rguilmet/RTK-Rover/docs/hyper-context-anchor.md

# Hyper-Context Anchor

## 1. CORE TECHNICAL ARCHITECTURE & STACK
* **Hardware:** Waveshare ESP32-S3-Touch-LCD-3.5B (`320x480` Portrait QSPI `AXS15231B` display, Capacitive Touch `0x3B`, `AXP2101` PMIC `0x34`, `TCA9554` IO Expander `0x20`, `PCF85063` RTC `0x51`, `QMI8658` 6-DOF IMU `0x6B`, `ES8311` Audio Codec `0x18`), Holybro H-RTK Unicore UM982 Dual-Antenna RTK GNSS module, and Ebyte E220-900T30S 900MHz LoRa module.
* **Firmware:** Multi-task dual-core FreeRTOS architecture (`Core 0` `RoverCore0` Priority 4 for real-time E220 $\rightarrow$ UM982 COM2 RTCM3 streaming, UM982 COM1 NMEA/`UNIHEADINGA`/`BASEINFOA` parsing, and 30 Hz 3D lever-arm kinematics with `<= 2 ms` `g_waypoint_change_seq` wakeup and zero I2C access; `Core 1` for `RoverAudio` Priority 4 `< 1 ms` ES8311 I2S `beepQueue` synthesis, `lvgl_port_task` Priority 3 LVGL 9 rendering & `0 ms` same-frame button callbacks, `RoverUI` Priority 2 exclusive `I2C_NUM_0` peripheral polling & screenshot generation, and `loopTask` Priority 1 5s debounced settings persistence + lossless SD log flushing).
* **UI:** LVGL 9 (`320x480` Portrait) with a persistent 4-row Top Status Header Bar (Date/Time with `minutesOffsetToUTC`, SI/IMP badge, Wi-Fi badge, AXP2101 battery telemetry, Master Fix badge, Master SVs, accuracy, RTCM age, Slave Fix badge, Slave SVs, baseline length, true heading, and streamlined ground-tip coordinates in 14pt Montserrat) above 5 functional screens (Multi-Mode Navigation Workspace with Tactical Guidance, Line Stakeout, and Map View on Tile 0; Field Survey Logger & Consolidated 3x4 Quick Settings Deck on Tile 1; Multi-File CSV Browser on Tile 2; Dual-Antenna Compass & Bubble Level on Tile 3; and Hardware Diagnostics & Live Observers on Tile 4) navigated strictly via the persistent Bottom Screen Navigation Bar (`< Prev`, `X/5: Title`, `Next >`). Horizontal swipe gestures are disabled.
* **Base Station Architecture (`pi4b-rtkbase`):**
  - Raspberry Pi 4B running RTKBase with RTCM TCP service on port `5016` (`tcp://127.0.0.1:5016`).
  - Stream explicitly filtered via `str2str` line: `"1006(5),1074,1084,1094,1230(10)"` producing ~625–650 Bytes/s.
  - Python hardware pacer `e220_pacer.py v3.4.0` runs as `systemd` service (`e220-pacer.service`) with `TIOCEXCL` exclusive UART locking, startup Mode 3 EEPROM verification, Channel 75 ambient noise floor probing, source `CRC24Q` validation, `GPIO 22` hardware reset watchdog (`>1.5s` `AUX` LOW), Section `5.6.2` two-regime `AUX` + silicon-calibrated Time-on-Air pacing, bi-directional 39B/45B uplink telemetry parsing / logging (`PWR:USB` vs `Bat:xx%`), remote over-the-air air-rate switching (`0x02`/`0x82`), terminal burst quiet-window enforcement, and Adaptive Constellation Interleaving at $\le 9.6\text{ kbps}$ (alternating secondary constellations across epochs while maintaining 1.0 Hz GPS 1074).
* **E220-900T30S Radio Specifications (Base & Rover Aligned, Profile Rev 2):**
  - Channel: `75` (`0x4B` = `925.125 MHz`, Rank `#1` cleanest US 902-928 MHz ISM channel in `test/e220-scan.csv` at `-96.23 dBm` avg, `+10.125 MHz` clear of `915.0 MHz` office Ecowitt weather station).
  - UART: `115,200 baud, 8N1` (`REG0 = 0xE6`).
  - Air Data Rate: `19.2 kbps` / `9.6 kbps` (supports remote over-the-air switching between 19.2k standard and 9.6k deep-woods canopy mode; also supports `2.4, 4.8, 38.4, 62.5`).
  - Subpacket Size: `200 Bytes` (`REG1` bits `[7:6] = 0b00`, native `400-byte` buffer atomic framing).
  - Mode 0 Live RSSI Register (`REG1` Bit 5 = `0x20`): Enabled (`REG1 = 0x23`), supporting `C0 C1 C2 C3 00 02` ambient noise + last-packet RSSI queries (dual `4-byte` `C1 00 <noise> <pkt>` and `5-byte` `C1 00 02 <noise> <pkt>` parser synchronized to post-`1094` inter-epoch quiet gap) without appending bytes to RX UART output (`REG3 = 0x00`).
  - Transmission Power: `21 dBm` (125 mW close/medium-range testing, keep `>= 30-100 ft` separation to avoid `+14 dB` RX LNA saturation) / `30 dBm` (1 W long-range field production) (`REG1 = 0x23` / `0x20`).
  - Transmission Mode: Transparent Mode 0 (M0=0, M1=0), LBT Disabled, Appended RSSI Byte Disabled (`REG3 = 0x00`).
  - Full Target Register Profile: `ADDH=0x00 ADDL=0x00 REG0=0xE5 REG1=0x23 CHAN=0x4B REG3=0x00` (at 19.2k).
* **Constraints & Kinematics:**
  - **Shared Internal I2C0 Bus (Core 1 Exclusive & UPS Warm-Reset Bus Clear):** All internal SMD peripherals share `I2C_NUM_0` on `GPIO 7` (SCL) and `GPIO 8` (SDA) at `400 kHz` (`.scl_wait_us = 20000` across all 6 devices including `TCA9554` and `ES8311`), polled exclusively from **Core 1** (`Touch 0x3B` @ 30Hz, `QMI8658 0x6B` 12-byte atomic burst @ 10Hz independent of LVGL graphics mutex, `PCF85063 0x51` @ 1Hz cached, `AXP2101 0x34` @ 0.5Hz) protected by `i2c_bus_mutex` with boot-time 18-clock GPIO SCL bus-clear + `STOP` (`i2c_bsp_gpio_bus_clear()`) to release any UPS-powered slave holding `SDA` LOW across warm resets, plus automatic `i2c_master_bus_reset()` recovery.
  - **Portrait IMU Coordinate Frame & 6-DOF Telemetry:** Accelerometer $a_y$ drives horizontal roll ($b_x$), $a_x$ drives vertical pitch ($b_y$). Gyroscope measures angular rate at 64 LSB/(deg/s). Resting flat produces $(0.0^\circ, 0.0^\circ)$.
  - **Storage Auto-Routing & Settings Mirroring:** MicroSD card is primary (`/sdcard/`) with internal `FFat` as emergency fallback. On boot and whenever settings change, `settings.json` is automatically mirrored from SD card to `FFat`.
  - **Device-Relative UART Pin Labels:** All pin labels (`UM982_TXD0`, `UM982_RXD0`, `UM982_TXD1`, `UM982_RXD1`, `E220_TXD`, `E220_RXD`) are named relative to the external module (`<DEV>_TXD` = module output $\rightarrow$ ESP32 RX input; `<DEV>_RXD` = module input $\leftarrow$ ESP32 TX output).
  - **Dual-Antenna Lever-Arm & Pole Height Projection:** The UM982 reports the WGS84 position of the **Master Antenna**, while the survey pole centerline sits at the midpoint ($\frac{B}{2} = 0.2775\text{ m}$ for `0.555 m` spacing) between Master and Slave antennas at height `antenna_height_m` above the ground tip. `nav_engine` projects the Master position along the 3D `UNIHEADINGA` baseline vector (`heading`, `pitch`) to eliminate orbital offset when rotating the pole.
  - **Display Orientation Independence:** True heading comes strictly from the pole-mounted UM982 dual antennas, while the handheld Waveshare's `QMI8658` IMU tracks the enclosure gravity vector (`Held Flat`, `Viewing Angle`, `Clipped Vertically to Pole`) and supports bracket tilt taring for the 2D pole bubble level.
  - **Internal `DRAM0` Conservation & Octal PSRAM Partitioning (`v0.7.5`):** Prebuilt Arduino-ESP32 `3.3.x` (`qio_opi`) sets `CONFIG_SPIRAM_MALLOC_ALWAYSINTERNAL = 4096` and `CONFIG_SPIRAM_MALLOC_RESERVE_INTERNAL = 0`, and disables `CONFIG_SPIRAM_ALLOW_BSS_SEG_EXTERNAL_MEMORY`. All non-DMA buffers $\ge 1\text{ KB}$ (`serial_logger` `32 KB`, `g_waypoints` `25.6 KB`, `rtcm_logger` `16 KB`, `nmea_logger` `8 KB`) are allocated in 8 MB Octal PSRAM via `heap_caps_malloc(..., MALLOC_CAP_SPIRAM | MALLOC_CAP_8BIT)` (keeping static `.dram0.bss` at `37.1 KB` / `18%` global dynamic RAM), and `create_rover_ui()` wraps ~400+ LVGL 9 widgets (`~50 KB`) in scoped `heap_caps_malloc_extmem_enable(64)` (restoring `4096` immediately afterward), preserving `~148 KB` of contiguous internal 8-bit/DMA SRAM for `esp_wifi_init()` / BLE and hardware DMA engines.
* **Code Style & Repository Architecture:**
  - Strict C/C++ for firmware (`src/` modular subdirectories), pure Python for auxiliary scripts (`scripts/`). Maintain existing docstrings. Semantic versioning enforced (`ROVER_FIRMWARE_VERSION` in `user_config.h` for firmware).
  - **Public Core vs. Private Sibling Repository:** Public `RTK_Rover` houses open-source firmware, generic mathematical tools (COGO solver, pacer, config utilities), schemas, and fictional sample data. Private `RTK_Rover_Private` houses real deed records, personal boundary JSON files, raw telemetry captures, and personal credentials under independent local Git version control.

---

## 2. BEHAVIORAL PROFILE & PROMPTING PERSUASION
* **Persona:** Professional Principal Level Embedded Systems Software Engineer & Geodesic/GNSS Firmware Architect.
* **Tone:** Highly terse, clinical, authoritative, and deeply rooted in physical hardware constraints (UART ringbuffer throughput, WGS84 ellipsoid radii, lever-arm kinematics, I2C bus arbitration). Zero conversational fluff. No preachy summaries.
* **Execution:** Do not output placeholder code (e.g., `// ... rest of function`). Provide complete, drop-in implementations.
* **Documentation Hygiene:** Explicitly update `docs/project_overview.md`, `docs/session_handoff.md`, and `CHANGELOG.md` in lockstep with architectural changes. Ensure all logical chunks of work are cleanly committed to Git.

---

## 3. HARD ROADBLOCKS & COMPULSIVE HALTS (WHAT NOT TO DO)
* **NEVER** assume RTKBase port 5016 carries unfiltered raw receiver output. The stream is strictly filtered via `str2str` to `1006(5),1074,1084,1094,1230(10)` (~630–650 B/s). Do not confuse it with local raw `GNSS-1.rtcm3` files.
* **NEVER** misinterpret E220 `AUX=1` as RF transmission complete! Per E220 Manual Section `5.6.2`, `AUX=1` means the 400-byte UART buffer emptied into the LLCC68 chip: `<200B` single-subpacket frames keep `AUX=1` throughout RF TX (must pace by calculated Time-on-Air + guard), while `201..400B` two-subpacket frames raise `AUX=1` the instant Subpacket 2 (`len - 200`) **starts** RF TX (must sleep `toa(len - 200) + guard` after `AUX` rising edge).
* **NEVER** forward unverified raw bytes from E220 UART directly to `UM982 COM2` without passing the `rx_stage` `CRC24Q == 0` Gatekeeper; truncated head subpackets cause `UM982 COM2` to swallow subsequent valid `0xD3` preambles.
* **NEVER** use single-precision `float` for WGS84 Latitude or Longitude storage or geodesic math (`float` has only ~24 bits of mantissa $\approx 1.5\text{ m}$ resolution at mid-latitudes, completely destroying centimeter-level RTK precision). Always use 64-bit `double` (`%.8f`).
* **NEVER** wrap I2C sensor reads inside the LVGL graphics mutex `rover_lvgl_lock()`. Sensor polling runs on Core 1 independent of LVGL render frame times, protected by `i2c_bus_mutex`.
* **NEVER** touch LVGL widget pointers from outside `lv_timer_handler()` without acquiring `rover_lvgl_lock()` and releasing via `rover_lvgl_unlock()`.
* **NEVER** use `lv_label_set_text_fmt()` with floating-point specifiers (`%f`); because the global Arduino LVGL library compiles with `LV_USE_FLOAT = 0`, `lv_vsnprintf_inner` skips `%f` without advancing `va_arg(va, double)`, causing subsequent arguments to crash (`LoadProhibited`). Always format floats with standard C `snprintf(buf, sizeof(buf), ...)` followed by `lv_label_set_text()`.
* **NEVER** execute filesystem operations (such as scanning `/survey_logged_pins.csv` or calling `save_settings()`) inside the 30 Hz UI rendering update loop (`RoverUI`) or LVGL button callbacks (`lvgl_port_task`). Dynamic identifiers must be served from the 64-entry RAM `s_stem_cache`, and debounced `save_settings()` must run strictly on the Priority-1 background `loop()` with `last_settings_change_ms` written *before* `settings_dirty = true` (signed `(int32_t)(now_ms - dirty_ts) >= 5000` check) and smart `FFat` mirror skip (`non_index_settings_equal()`) when only `active_waypoint_index` changes while MicroSD is mounted.
* **NEVER** use a process-wide boolean (`s_in_logger`) to guard `serial_logger` re-entrancy across FreeRTOS tasks, as concurrent tasks (`lvgl_port_task`, `wifi_connect`) will silently drop log lines whenever `loop()` is flushing to SD; always use task-scoped `s_io_owner_task == xTaskGetCurrentTaskHandle()` re-entrancy protection and decouple `s_serial_mux` ring-buffer pushes from `s_serial_file_mux` VFS writes.
* **NEVER** declare non-DMA ring buffers, lookup tables, or waypoint arrays $\ge 1\text{ KB}$ in static `.dram0.bss` (or rely on `EXT_RAM_BSS_ATTR`, which is inactive in prebuilt Arduino-ESP32 `sdkconfig.h`). Always allocate in Octal PSRAM via `heap_caps_malloc(..., MALLOC_CAP_SPIRAM | MALLOC_CAP_8BIT)` and keep static global dynamic RAM $\le 25\%$ (`< 80 KB`); otherwise `esp_wifi_init()` / `esp_wifi_start()` silently fails with `ESP_ERR_NO_MEM` (`0x101`) under `DebugLevel=none`, leaving Wi-Fi stuck at `WL_STOPPED (254)`, `scanNetworks() == -2`, `WiFi.begin() == 4`, and `softAPIP() == 0.0.0.0`.
* **NEVER** leave `heap_caps_malloc_extmem_enable(<4096)` lowered globally across peripheral initialization; scope `heap_caps_malloc_extmem_enable(64)` strictly around `create_rover_ui()` and restore `4096` immediately afterward so `SD_MMC`, `FFat`, `I2S`, `SPI`, `WiFi`, and `BLE` drivers never receive PSRAM pointers for internal DMA descriptors.
* **NEVER** use non-ASCII Unicode characters (such as $\pm$, $\circ$, degree symbols, arrows) in UI strings or web portals; standard ASCII equivalents (`+/-`, `deg`, `->`, `[v]`, `[^]`) must be used to ensure font glyph compatibility.
* **NEVER** trigger waypoint logging from a short-press of the BOOT button (GPIO 0). Physical BOOT button is reserved exclusively for long-press ($\ge 1.5\text{ s}$) screenshots.
* **NEVER** hardcode domain data, personal identifiers, specific coordinates, local absolute filesystem paths (`file:///C:/...`), or private configuration records directly into computational logic or algorithms. All tools must follow state-of-the-art software engineering practices: strict separation of Code (logic) and Data (schemas/CLI inputs).
* **NEVER** commit, stage, or push personal identifiable information (PII), private amateur radio callsigns, private homestead coordinates, personal LAN hostnames, or private deed boundary solving data to the Git repository. Personal data must strictly remain in the sibling repository `RTK_Rover_Private` (or `reference/` which is `.gitignore`'d).
* **NEVER** push commits to GitHub without executing the secrets audit scanner (`python scripts/check_secrets.py`) and verifying zero violations. An automated Git `pre-push` hook enforces this check.

---

## 4. LOGISTICAL STATE & COMPLETED MILESTONES
* **Completed (`v0.2.49`):**
  - **Web Portal UTF-8 / ASCII Sanitation:** Eliminated multi-byte emoji mojibake across sorting buttons and table headers. Added explicit UTF-8 meta tags and response headers.
* **Completed (Oct 29 - E220 Radio Link Integration & Pacing):**
  - **E220-900T30S Full Profile Alignment:** Synchronized Base and Rover to 115,200 baud, 19.2k air rate, 200B subpackets, CH 55 (905.125 MHz), 21 dBm, Transparent Mode (`REG0=0xE5, REG1=0x03, CHAN=0x37, REG3=0x00`).
  - **`e220_pacer.py` (v1.2.0):** Developed closed-loop hardware pacing daemon on Raspberry Pi for RTKBase TCP stream with auto-config and post-write AUX falling/rising edge monitoring.
  - **`set_e220_power.py` (v1.0.0):** Created live power level switching utility for Pi.
  - **Link Diagnostics (`test/_013`, `_014`, `_015`):** Diagnosed Test 013 baud mismatch. Verified Test 014 100% byte conservation and decoded Msg 1006 and Msg 1084 with CRC Valid. Diagnosed dropped tail packets on multi-packet frames (>200B) due to missing post-write AUX wait, resolved in `e220_pacer.py` v1.2.0. Verified Test 015 base pacing with 2,961 packets, 109.0 ms exact air time pacing, 45.8% duty cycle, and zero warnings across 11.8 minutes.
* **Completed (`v0.2.53` & `e220_pacer.py v2.7.0` - Oct 30):**
  - **Forensic Diagnosis of `_018`..`_021-new-pacer`:** Proved binomial $p = 3.49\%$ subpacket reception rate across `1,291` RF subpackets (`96.5%` physical RF packet loss), discovered E220 Section `5.6.2` `AUX` FIFO-empty timing quirk (`500 ms` false timeouts on `<=200B`, Subpacket 2 air collision on `>200B`, and four `4.0 s` Base lockups), and proved `UM982 COM2` preamble-swallowing on truncated head subpackets (`31%` valid frame loss). Confirmed Base E220 on 5V rail with `100 uF + 0.1 uF` decoupling and `serial-getty@ttyAMA0.service` disabled (single PID on `/dev/ttyAMA0`).
  - **Rover `v0.2.53`:** Implemented 1,536-byte Sliding-Window Store-and-Verify RTCM3 Gatekeeper (`CRC24Q == 0` before atomic `UM982 COM2` write; verified 13/13 frame recovery & 0 corrupt bytes on Test `_021` capture), `IO21` `AUX` edge-counter ISR, and non-blocking 5s Mode 0 `Noise/Pkt RSSI` (`dBm`) polling (`REG1 = 0x23`) displayed on Tile 4 and `[TELEM]`.
  - **Base `e220_pacer.py v2.7.0`:** Implemented Section `5.6.2` two-regime pacing (`<=200B` ToA pacing + `201..400B` `AUX` rise + Subpacket 2 ToA + `35 ms` guard), `GPIO 22` hardware reset watchdog (`>1.5 s` `AUX` LOW), `TIOCEXCL` UART lock, source `CRC24Q` gate, and startup Channel 55 ambient RF noise probe.
* **Completed (`v0.2.54` / `v0.2.55` & `e220_pacer.py v2.8.1` - Oct 30 - Nov 1):**
  - **Spectrum Scan (`test/e220-scan.csv`) & Test `_022` + 16-Test Historical Audit:** Relocated Base antenna via 4-ft coax and scanned `CH 52..77`, identifying **`CH 75` (`925.125 MHz`)** as `#1` cleanest US ISM channel (`-96.23 dBm` avg, `-94 dBm` peak, `+10.125 MHz` clear of `915.0 MHz` Ecowitt). Decoded Test `_022` raw `rtcm-base_*.txt` Mode 0 RSSI bytes (`C1 00 A1 E3` = `-95 dBm` noise / `-29 dBm` packet; `C1 00 9E E0` = `-98 dBm` noise / `-32 dBm` packet), proving ultra-clean Rover self-noise, `4-byte` MCU RSSI reply format, and close-range indoor `+21 dBm` TX + `+14 dB` RX LNA front-end compression at `~5 m`. Audited all 16 historical wire-taps (`_005`..`_022`), proving native `400-byte` buffer atomic framing delivered `223` intact `> 200B` frames (`Fix: 4`) at `38.4k`/`62.5k` vs `0` across `8` consecutive `19.2k` tests (passive `32 MHz` `XTAL` thermal/carrier drift on 1W PA bursts).
  - **Base `e220_pacer.py v2.8.1` & `e220-pacer.service`:** Restored `38.4 kbps` Air Data Rate (`REG0 = 0xE6`), migrated to `CH 75` (`925.125 MHz`, `CHAN = 0x4B`), calibrated `estimate_subpacket_air_s()` to measured `AUX_low` silicon timing (`148.1 ms` for `200B` @ `19.2k` -> `82.2 ms` for `200B` @ `38.4k`), and added dual `3/4-byte` ambient noise probe parsing.
  - **Rover `v0.2.55`:** Added `ROVER_E220_PROFILE_REV = 2` one-time `/settings.json` auto-migration (`CH 75 / 38.4k` without overwriting Wi-Fi or geometry), dual `4-byte` / `5-byte` Mode 0 RSSI reply parser (`80 ms` timeout), epoch-synchronized post-`1094` RSSI polling, hardware AUX edge counter ISR, and granular RTCM message telemetry (`1006`, `1074`, `1084`, `1094`, `1230`) with strict ASCII serial formatting.
* **Completed (Nov 2-3, 2026 - Sibling Architecture & Cadastral Decoupling Phases 1-5):**
  - **Git History Sanitization & Automated Pre-Push Protection (Phase 1):** Force-purged private tokens from git history. Implemented parameterized scanner `scripts/check_secrets.py v1.1.0` dynamically loading unversioned `.secrets.local`. Installed active `.git/hooks/pre-push` verification hook.
  - **Dedicated Sibling Repository `RTK_Rover_Private` (Phase 2):** Initialized independent local git tracking at `../RTK_Rover_Private`. Migrated 22 registered deed PDFs, historical solvers, raw wiretaps, and private configurations. Scrubbed all private assets from public `RTK_Rover`.
  - **Cadastral Schema & Generic COGO Engine `cogo_solver.py v1.1.0` (Phase 3):** Published standard schema `docs/schemas/cadastral_schema.json` and fictional reference dataset `examples/subdivision_demo.json`. Developed generic COGO engine with WGS84 geodesic projections, automatic grid convergence calibration, loop misclosure ratio evaluation, Bowditch adjustment, circular curve solving, adjoiner snapping, and multi-format exporters (Rover 19-column CSV, Google Earth KML, RFC 7946 GeoJSON, AutoCAD DXF, and ASCII reports).
  - **Homestead Parcel Extraction & Sub-Millimeter Parity Validation (Phase 4):** Modeled 9 property traverses and ROW curves in `RTK_Rover_Private/cadastral/homestead_parcels.json`. Verified sub-millimeter mathematical parity against historical solvers across all 37 benchmark points (max delta $0.7834\text{ mm}$, 100% PASS). Archived legacy solvers to `cadastral/legacy/`.
  - **Master Documentation Audit & Clean Release Verification (Phase 5):** Synchronized `README.md`, `docs/project_overview.md`, `GEMINI.md`, `docs/hyper-context-anchor.md`, `docs/session_handoff.md`, and `docs/cogo_solver_guide.md`. Executed full pre-push audit with 100% clean status.
* **Completed (Nov 4-5, 2026 - Bi-Directional LoRa, Visual Overhaul, Interleaving & Phase 5 Navigation `v0.5.0`..`v0.6.0`):**
  - **Bi-Directional Telemetry & Remote Air-Rate Switching (`v0.5.0`..`v0.5.1`):** Developed 39-byte CRC16-protected telemetry frame (`0xAA 0x55`) streaming sub-millimeter coordinates, fix quality, satellite counts, heading status, and battery telemetry from Rover to Base in the half-duplex quiet window. Implemented zero-credential touchscreen remote air-rate switching (`19.2k` <-> `9.6k`) with automatic 60s rollback watchdog.
  - **Line Stakeout Mode & Map View with Zoom/Pan (`v0.5.2`):** Implemented tri-state navigation badge cycling between Tactical Guidance, Line Stakeout, and Map View. Overhauled Line Stakeout with 4-row readout (16pt offset magnitude, ASCII steer cues `<<<`/`>>>`, station progress, and deed bearing), Point A/B baseline with traverse chevron, perpendicular tie-line, and one-tap line swap (`[<-> SWAP]`). Implemented interactive 2D Map View with single-touch drag pan, right-edge HUD Zoom buttons (`[+]`, `[-]`, `[FIT]`, `[CTR]`), boundary polyline with closed loop, waypoint pins, breadcrumbs, and live heading beam.
  - **Rate-Adaptive LoRa Truncation & Settings Dual-FS Sync (`v0.5.2`):** Scaled broken-frame truncation timeouts to prevent multi-subpacket frame drops at slower baud rates (650 ms at 9.6k, 1200 ms at 4.8k, 280 ms at 19.2k). Fixed settings dual-FS synchronization in web portal `handleUpload()`, ensuring simultaneous mirror writes to both FFat and MicroSD.
  - **Adaptive Constellation Interleaver & Font Fix (`v0.5.3` & `e220_pacer.py v3.2.0`):** Replaced undeclared Montserrat 20 with Montserrat 16 in LVGL port to resolve Arduino IDE compilation error. Implemented self-adaptive constellation interleaver in `e220_pacer.py v3.2.0` to prevent 9600 baud channel saturation (GPS 1074 sent at 1.0 Hz; GLONASS 1084, Galileo 1094, BeiDou 1124 alternated across epochs; guaranteed 200 ms quiet window even when terminal frames are skipped).
  - **Phase 5 Navigation, Cadastral Ordering & Deep-Woods Heading Fallback (`v0.6.0`):** Implemented signed `poly_order` sequence schema in CSV loader and Map View renderer (closed polygon loops for positive order, dashed tie-lines for $-k$ ties, standalone for 0). Decluttered Line Stakeout canvas. Eliminated touch latency (20 ms LVGL delay + in-memory RAM suffix cache). Implemented velocity-independent $\ge 0.70\text{ m}$ displacement heading ("Walk 3 Steps") and QMI8658 gyro yaw tracking (60s hold) preventing heading loss under dense forest canopy.
  - **Rover Telemetry Expansion for ANT2 Observability & Lockstep Pacer (`v0.6.1` & `e220_pacer.py v3.3.0`):** Expanded binary uplink telemetry from 39 to 45 bytes (+6B) adding secondary antenna fix status (`SLV_FIX`/`SLV_FLT`), measured 3D baseline length (`baseline_mm`), crossbar pitch (`baseline_pitch_cdeg`), and explicit heading source (`DUAL_FIX`, `WALK`, `GYRO`, `COG`, `HOLD`). Implemented dual-format auto-detecting unpacker in `e220_pacer.py v3.3.0` with extended console heartbeat, RAM tmpfs JSON, and daily CSV columns.
  - **Telemetry Fusion Core Sync & Pure ASCII Heartbeat (`v0.6.2` & `e220_pacer.py v3.3.1`):** Synchronized telemetry state feed to Core 1 post-sensor-fusion (fixing zero battery `0% (0.00V)` and `[NONE]` heading bugs), aligned `ant2_fix_type` strictly with moving-baseline status (`SLV_FIX` only when integer locked; `NONE` when baseline rejected), and replaced Unicode degree symbols with clean ASCII `deg` eliminating terminal mojibake (`Â°`).
* **Completed (Nov 5-6, 2026 - Dual-Power UPS, Spacing Overhaul, Wi-Fi Netif Recovery & Internal `DRAM0` / PSRAM Architecture `v0.7.0`..`v0.7.5`):**
  - **Dual-Power & Hot-Swap UPS Architecture (`v0.7.0` & `e220_pacer.py v3.4.0`):** Configured AXP2101 PMIC constant-current charging to $500\text{ mA}$ for safe LiPo buffer maintenance. Implemented 14-bit VBUS line voltage monitoring (`vbus_voltage_v >= 4.0V`) with 2-cycle hysteresis filter: external 5V pack powers high-drain UM982 and E220 1W LoRa radio, while the internal battery keeps the ESP32-S3 and LCD continuously alive across power interruptions with zero rebooting. Added configurable auto-shutdown battery timer (`auto_shutdown_battery_min`, default 5 min). Re-architected Row 1 header spacing and minimalist power badge (`[USB] 5.04V+` / `[Bat] 85% 3.92V`). Base Station pacer updated to `v3.4.0` formatting power as `PWR:USB` vs `Bat:xx%`.
  - **Wi-Fi Portal IP Fix & Deep-Woods Gyro Freeze (`v0.7.1`):** Resolved SoftAP fallback `0.0.0.0` IP bug with static IP configuration (`192.168.4.1`) and readiness polling. Added fast-path bypass for unconfigured SSIDs. Eliminated stationary heading gyro drift by increasing deadband to $1.5^\circ/\text{s}$ and freezing heading (`HDG HLD` at $0.0^\circ/\text{s}$ drift), with active pivot tracking (`HDG GYRO`) and 3.0-second walk persistence (`HDG WALK`).
  - **Wi-Fi Multi-State Visual Cues & Core v3.3.12 Netif Preservation (`v0.7.2`):** Replaced destructive `WiFi.disconnect(true)` with non-destructive calls and clean SoftAP teardown, resolving Arduino-ESP32 v3.3.12 `WL_STOPPED (254)` driver halt loops. Implemented multi-state color coding on Tile 1 Wi-Fi button (`WIFI: CONN` Amber `#D97706`, `WIFI: STA` Green `#107C41`, `WIFI: AP` Violet `#7C3AED`, `WIFI: OFF` Blue `#1B6CA8`) and matching Row 1 header icons.
  - **Wi-Fi Core 1 Task Affinity (`v0.7.3`..`v0.7.4`):** Pinned background `wifi_connect` task to Core 1 at Priority 3 co-located with `arduino_events`, eliminating Core 0 RTCM task priority inversion.
  - **Internal `DRAM0` Exhaustion Root-Cause Resolution & PSRAM Migration (`v0.7.5`):** Binary ELF analysis (`xtensa-esp32s3-elf-size`) and serial timestamp delta analysis (`test/_033`) proved static `DRAM0` usage (`213.3 KB`, `.dram0.bss = 120,032 B`) plus LVGL widget heap allocations had starved `esp_wifi_init()` / `esp_wifi_start()` of internal SRAM (`ESP_ERR_NO_MEM` hidden under `DebugLevel=none`). Migrated `82,944 B` of logger/waypoint `.dram0.bss` buffers and `~50 KB` of LVGL 9 widgets to 8 MB Octal PSRAM (dropping `.dram0.bss` to `37,104 B` / `18%` global dynamic RAM), trimmed `LVGL_DMA_BUFF_LEN` to 24 lines (`15,360 B`), restored `WIFI_ALL_CHANNEL_SCAN` / `WIFI_AUTH_WPA_PSK`, and added `[MEM] Post-Setup Heap` + `WiFi.mode()` diagnostics.
  - **UPS Warm-Reset I2C0 Bus-Clear & TCA9554/ES8311 Timing Fix (`v0.7.6`):** Resolved 30 ms `RTC_SW_CPU_RST` panic loop (`E(26) i2c.master: I2C transaction timeout detected` at `esp_io_expander_new_i2c_tca9554`) caused when a warm/flash reset interrupted an active multi-byte I2C read while the AXP2101 LiPo UPS kept all 6 I2C slaves continuously powered and holding `SDA` LOW. Added 18-clock GPIO open-drain SCL bus-clear + `STOP` (`i2c_bsp_gpio_bus_clear()`), set `.scl_wait_us = 20000` + `400 kHz` + `i2c_bsp_lock()` in `tca9554` and `ES8311` drivers, and replaced fatal `ESP_ERROR_CHECK` expander calls with a 5-attempt `i2c_bsp_reinit_bus()` recovery loop.
  - **Real-Time Priority-4 Audio, Zero-Lag Same-Frame Waypoint Selection & Lossless SD Logging (`v0.7.7`):** Diagnosed and resolved `test/_034` ~1s waypoint/file button lag caused by unsigned timestamp underflow `(uint32_t)(now_ms - last_settings_change_ms)` triggering synchronous 4-file `save_settings()` (`0.8–2.18 s` `FFat` wear-leveling stall) on `RoverUI` before `beepQueue` was drained. Extracted `beepQueue` into dedicated Priority-4 `RoverAudio` task (`< 1 ms` tactile audio), added `refresh_t0_guidance_readout_immediately()` (`0 ms` same-frame readout update) + `g_waypoint_change_seq` (`<= 2 ms` Core 0 wake), moved `save_settings()` to Priority-1 `loop()` with 5s signed quiet debounce and smart `FFat` mirror skip (`non_index_settings_equal()`), rewrote `waypoint_load_csv()` with `512 B` stack chunk parsing (`< 5 ms`) and 64-entry ring `s_stem_cache`, fixed dropped concurrent SD serial logs via task-scoped `s_io_owner_task`, and added `WIFI: CONN` tap-to-cancel + instant portal readiness before NTP.
  - **Phase 8 Single-UART `UM982 COM1` Consolidation, Receiver State Audit & Auto-Detected 9-DOF `MMC5983MA` Compass (`v0.8.0` & `e220_pacer.py v3.4.1`):** Consolidated all UM982 traffic (`RTCM3` + ASCII commands TX, `NMEA`/`UNIHEADINGA`/`BASEINFOA` + command responses RX) onto `Serial1` (`COM1`, `GPIO 17/18` @ `115200` baud) with `s_com1_tx_mutex`, `4096 B` RX/TX ring buffers, and a 3-way line demultiplexer (`512 B` buffer + XOR checksum gate), freeing `Serial2` (`COM2`, `GPIO 47/48`) and ~6 KB internal `DRAM0`. Added `um982_query_receiver_state()` (`VERSIONA`, `MODE`, `CONFIG`, `LOGLIST`) and Tile 4 `[UM982 RECEIVER STATE & LOGLIST]` card. Added auto-detected `MMC5983MA` (`0x30`) 18-bit 3-axis AMR magnetometer driver (`src/mag_bsp/`) with hardware `SET`/`RESET` bridge offset cancellation, continuous `UM982 HDG FIX` True-North tare learning, iron anomaly rejection (`> 3.5 uT`), and 9-DOF heading fallback (`HDG_SRC_COMP = 7` / `HDG CMP`).
* **Current Status:** Firmware `v0.8.0` and Base Station Pacer `e220_pacer.py v3.4.1` fully built, verified, and operational. Preparing next development phase: `Field-Instrument-Core` consolidation and `RTK-Rover-Mobile` Android port with ESP32 sensor & radio bridge.
