rguilmet/RTK-Rover/docs/session_prompt.md

# Session Kickoff Prompt: RTK-Rover-Mobile

> **Usage:** Copy and paste the prompt below into a new Antigravity session to initiate the **RTK-Rover-Mobile** Android project.

---

```markdown
# Session Goal: RTK-Rover-Mobile (Android Application + ESP32 Hardware Bridge)

## 1. Project Overview & Objective
We are transitioning the user-facing survey experience of our dual-antenna RTK GNSS Rover to a dedicated Android mobile application called **`RTK-Rover-Mobile`**. 

We will use our existing **Waveshare ESP32-S3-Touch-LCD-3.5B** board as the physical **sensor and radio bridge** connected to the GNSS receiver and LoRa transceiver, communicating wirelessly with an Android smartphone running the primary user interface, cadastral mapping, NTRIP client, and survey data management.

---

## 2. System Architecture & Component Roles

```
+-------------------------------------------------------------+
|              ANDROID SMARTPHONE (RTK-Rover-Mobile)          |
|  - Modern Sunlight-Readable UI (Kotlin / Jetpack Compose)   |
|  - High-Resolution Map Engine (Google Maps / MapLibre)      |
|  - Cellular NTRIP Client (rtk2go.com:2101 / Standish Base)  |
|  - Tri-Mode Stakeout (Tactical Bullseye, Line, 2D Cadastral)|
|  - Survey Point Logging, Multi-Epoch Averaging & CSV Export |
|  - Hands-Free Audio Guidance (Proximity Geiger & Voice)     |
+------------------------------+------------------------------+
                               ^
               Bluetooth LE (NUS) / Wi-Fi UDP
                               v
+-------------------------------------------------------------+
|    WAVESHARE ESP32-S3 BRIDGE (Hardware Interface Pod)       |
|  - Holybro UM982 GNSS (COM1 @ 115200 NMEA/Heading, COM2)   |
|  - Ebyte E220 900MHz LoRa (Transparent RTCM / Telemetry)    |
|  - Onboard QMI8658 6-DOF IMU (Pole Plumb Bubble Level)      |
|  - AXP2101 PMIC Power Telemetry & LiPo Battery UPS Buffer   |
|  - 3D Lever-Arm Kinematics (Ground-Tip Projection: 1.80m)   |
|  - Local MicroSD / FFat Backup Raw Logging                  |
+-------------------------------------------------------------+
```

### Component 1: Android Mobile Application (`RTK-Rover-Mobile`)
* **Platform:** Android (Modern Android SDK, Kotlin, Jetpack Compose, Coroutines/Flow).
* **Wireless Connectivity:** BLE Nordic UART Service (NUS) for ultra-low latency, battery-efficient telemetry streaming, with Wi-Fi UDP socket as a high-bandwidth alternative.
* **Cellular NTRIP Client:** Connects over mobile cellular data to RTK2go (`rtk2go.com:2101` or `3.14.70.106:2101`), pulls mountpoint `STANDISH_ME_FN43ur`, verifies RTCM3 frames (`1006, 1074, 1084, 1094, 1230`), and streams them over BLE/Wi-Fi to the ESP32 bridge $\rightarrow$ UM982 COM2.
* **Dual RTCM Source Arbitration:** Automatically manages or falls back between Local 900MHz LoRa (E220) and Cellular NTRIP (RTK2go) based on differential age and link health.
* **Full Survey Navigation Suite (Ported from Firmware v0.7.7):**
  * **Persistent Top Status Header Bar:** Date/time, power, ANT1 fix mode, SVs, precision, RTCM age, ANT2 heading fix, baseline length, true heading, and ground-tip coordinates.
  * **Tactical Guidance & Bullseye Stakeout:** Course-Up vector guidance with concentric centimeter rings ($1\text{ m}$, $20\text{ cm}$, $2\text{ cm}$) and proximity Geiger audio cues.
  * **Cadastral Line Stakeout:** Stationing ($S$), lateral offset ($O$), steer cues (`<<<`/`>>>`), and quadrant deed bearings ($S 62^\circ 15' 12" W$).
  * **2D Cadastral Map View:** Closed boundary polygons (`poly_order > 0`), dashed tie-lines (`-k`), color-coded pins, historical route breadcrumbs, and live heading beam.
  * **Survey Point Logger:** Symmetrical prefix dropdown (`PIN`, `PIPE`, `MONUMENT`, `<DERIVED>`), multi-epoch averaging ($1\text{s}$, $5\text{s}$, $10\text{s}$, $30\text{s}$), and collision-free `_Lxxx` numbering.

### Component 2: ESP32 Smart-Pole Hardware Bridge Firmware
* **Initial Prototype Bridge Board:** Waveshare ESP32-S3-Touch-LCD-3.5B (acts as the bridge during initial software bring-up).
* **Target Smart-Pole Board (Out of the Gate for Pole Assembly):** **Waveshare ESP32-S3-Touch-LCD-3.49-V2** (`640 × 172` 3.49" IPS bar display showing the top 4-row summary of Fix/Heading/Baseline/Link/Bat/Coords, integrated **18650 battery holder** with USB-C `ETA6098` charging, MicroSD card slot, onboard `QMI8658A` 6-DOF IMU & `PCF85063A` RTC, 16MB Flash, 8MB Octal PSRAM) housed in a beam-mounted electronics box on a removable **1" square aluminum tube crossbar** (`24"` / `610 mm` to `30"` / `762 mm` dual-helix GNSS antenna spacing + 900 MHz LoRa antenna + outboard **`MMC5983MA` 3-Axis AMR Magnetometer (`0x30`)** mounted `6"`–`10"` along the aluminum beam for Dual-GNSS-auto-calibrated 9-DOF woods heading `HDG COMP`). A discrete through-hole **`NDP6020P` P-FET + `2N3904` NPN** high-side switch gated by `J3 Pin 2 (3V3)` switches `J3 Pin 1 (VBAT)` into an **`MT3608` 5.0V boost converter** powering the Holybro UM982 and Ebyte E220-900T30S, engineered with crash-safe zero/minimal data-loss resilience on sudden power loss.
* **Firmware Baseline & Consolidated `Field-Instrument-Core` Library Repo (`Documents/Arduino/libraries/Field_Instrument_Core`):** All shared C/C++ drivers (`um982_driver`, `e220_driver`, `nav_engine`, `waypoint_manager`, `mag_bsp` (`MMC5983MA` & `RM3100`), `i2c_bsp` with 18-clock GPIO bus-clear + `i2c_bsp_lock()`, `tca9554` & `ES8311` with `.scl_wait_us = 20000` + `400 kHz`, Priority-4 `RoverAudio` tone synthesizer, `lvgl_port` with 24-line DMA buffers & PSRAM widget routing, task-scoped `s_io_owner_task` crash-safe `500 ms` pre-synced MicroSD logging, and `matrix_math`/`sensor_fusion`), board profiles (`3.5B` & `3.49-V2`), **all** shared Python/Base Station/COGO/security scripts (`scripts/e220_pacer.py`, `cogo_solver.py`, `kml_to_waypoints.py`, `validate_waypoints.py`, `setup_e220.py`, `setup_um98x.py`, `analyze_rtk_log.py`, `check_secrets.py`, `install_git_hooks.py`), and **all** hardware datasheets, schematics, CAD, and technical articles (`docs/`) are consolidated into a single generic Arduino library & GitHub repository: **`Field_Instrument_Core`** (`github.com/rguilmet/Field-Instrument-Core`). This supports separate, ultra-lean Arduino sketches (`Arduino/RTK_Rover` for the `3.5B` handheld, `Arduino/RTK_Smart_Pole` for the `3.49-V2` Smart Pole, and `Arduino/Magnetic_Field_Scanner` keeping only its magnetometry-specific calibration/plotting scripts) alongside the `RTK-Rover-Mobile` Android app.
* **CRITICAL ESP32-S3 Memory Guardrail (`DRAM0` vs. Octal PSRAM):**
  * Prebuilt Arduino-ESP32 (`3.3.x`, `qio_opi`) sets `CONFIG_SPIRAM_MALLOC_ALWAYSINTERNAL = 4096` and `CONFIG_SPIRAM_MALLOC_RESERVE_INTERNAL = 0`. Wireless stacks (`esp_wifi_init()` + BLE controller) strictly require contiguous internal 8-bit/DMA SRAM (`DRAM0`) and fail silently under `DebugLevel=none` (`ESP_ERR_NO_MEM` $\rightarrow$ `WL_STOPPED 254`) if `DRAM0` is exhausted.
  * Allocate all new bridge TX/RX ring buffers $\ge 1\text{ KB}$ in Octal PSRAM via `heap_caps_malloc(..., MALLOC_CAP_SPIRAM | MALLOC_CAP_8BIT)` (never in static `.dram0.bss`), prefer lightweight `NimBLE-Arduino` over legacy Bluedroid `BLEDevice`, and verify `[MEM] Post-Setup Heap` internal free SRAM stays healthy.

---

## 3. Reference Documentation & Key Artifacts
Before beginning, review these technical specifications in the workspace:
* **Firmware Master Docs:** `RTK_Rover/README.md`, `RTK_Rover/GEMINI.md`, `RTK_Rover/docs/project_overview.md`, `RTK_Rover/docs/hyper-context-anchor.md`, `RTK_Rover/docs/session_handoff.md`, `RTK_Rover/docs/user_manual.md`.
* **Smart Pole & App Architecture:** `RTK_Rover/docs/plan_smart_pole_and_android_app.md`.
* **Cellular NTRIP Bridge Architecture:** `RTK_Rover/docs/plan_phase7_cellular_ntrip_bridge.md`.
* **Cadastral Schema & COGO Engine:** `RTK_Rover/scripts/cogo_solver.py v1.1.0` and `RTK_Rover/docs/schemas/cadastral_schema.json`.

---

## 4. Immediate Tasks for This Session
1. **Initialize Project Scaffolding:** Set up the `RTK-Rover-Mobile` Android project structure (Kotlin, Jetpack Compose, Android Gradle Plugin).
2. **Define Bridge Protocol:** Formulate the compact binary or JSON telemetry and RTCM transfer protocol between ESP32 and Android over BLE NUS (GATT characteristics for Telemetry TX, RTCM RX, Commands).
3. **Develop Android BLE Connection Manager:** Implement scanning, pairing, and automatic reconnection with the ESP32 rover bridge.
4. **Implement Android Cellular NTRIP Client:** Build background NTRIP stream client for RTK2go mountpoint `STANDISH_ME_FN43ur` with CRC24Q verification and bridge forwarding.
5. **Implement Jetpack Compose UI Skeleton:** Construct the persistent 4-row status header bar and core navigation deck.
```
