rguilmet/RTK-Rover/docs/images/E220.webp

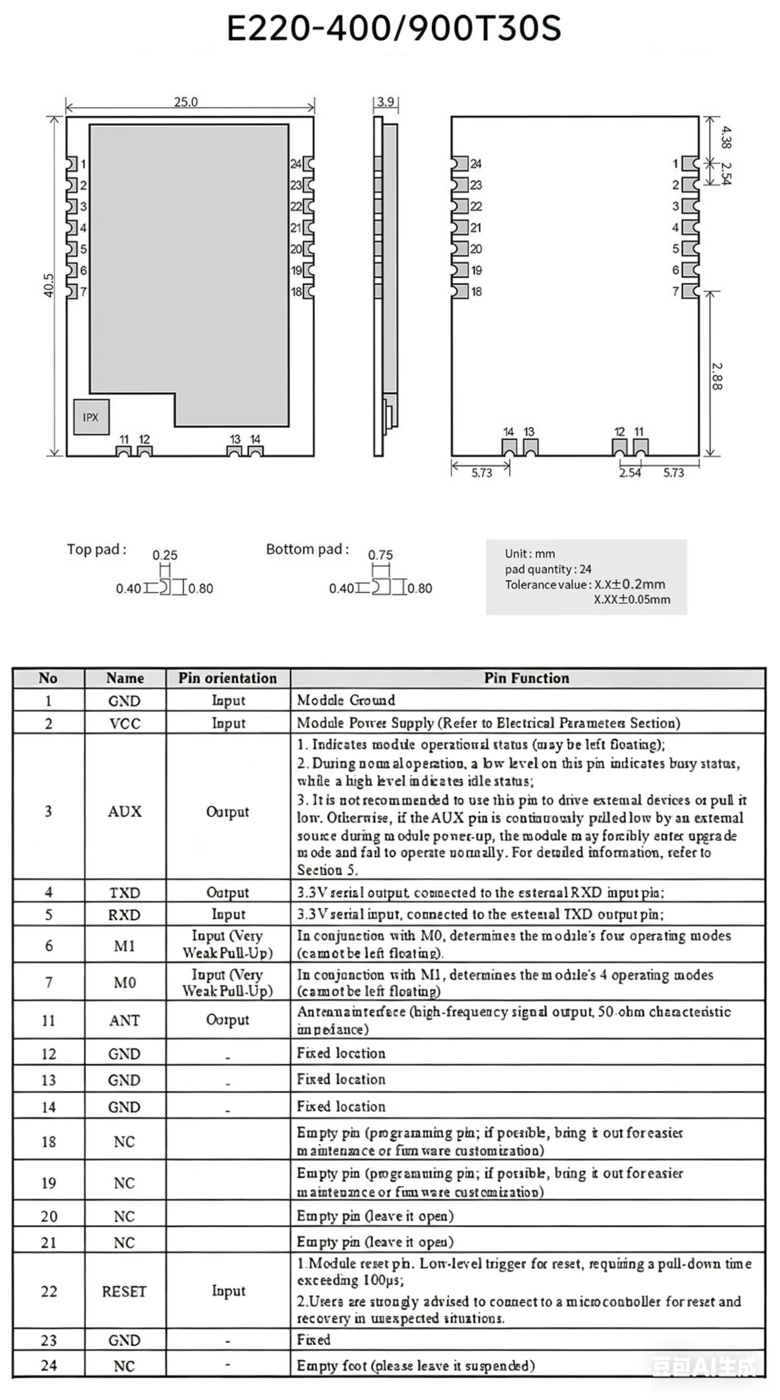
docs/images/E220.webp
