rguilmet/RTK-Rover/docs/images/ESP32-S3-Touch-LCD-3.5B-details-callouts.png

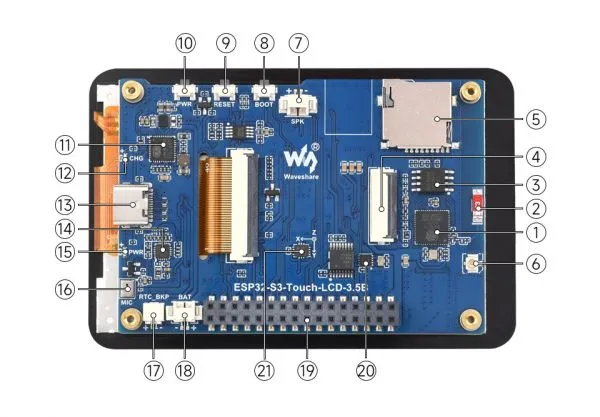
docs/images/ESP32-S3-Touch-LCD-3.5B-details-callouts.png
