rguilmet/RTK-Rover/docs/images/ESP32-S3-Touch-LCD-3.5B-Pinout-original.png

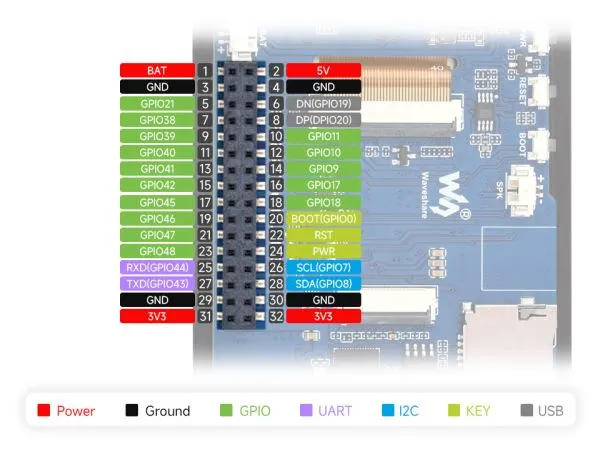
docs/images/ESP32-S3-Touch-LCD-3.5B-Pinout-original.png
