rguilmet/RTK-Rover/docs/images/Waveshare-ESP32-S3-Touch-LCD-3.5B-GPIO_Pin_Allocation.png

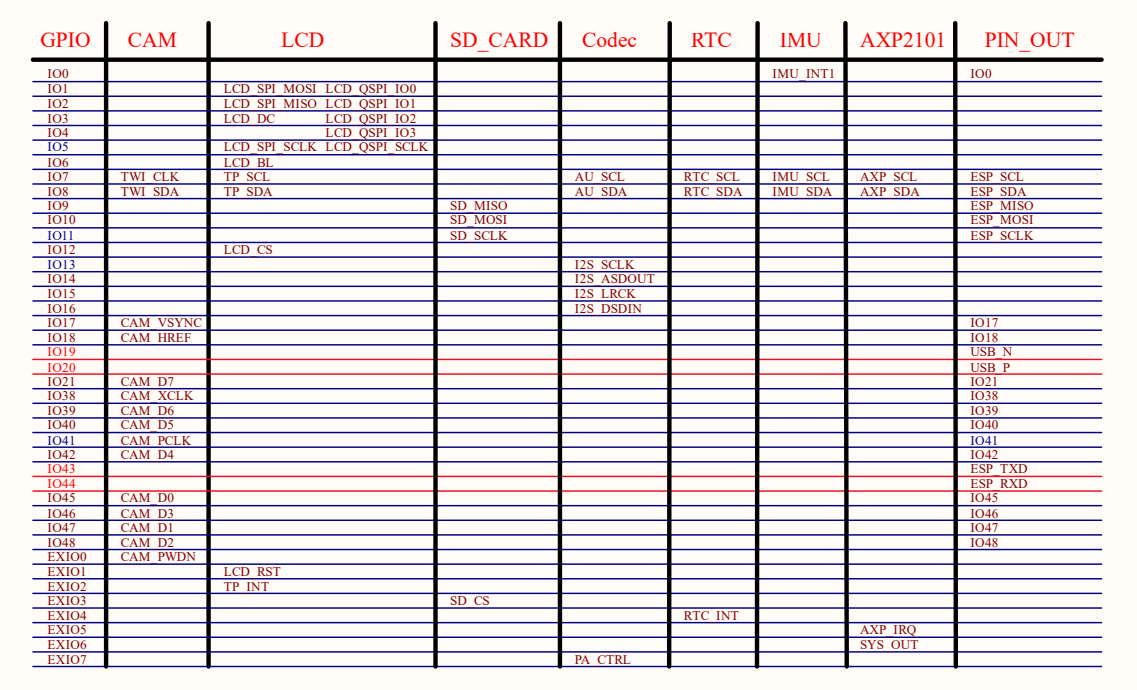
docs/images/Waveshare-ESP32-S3-Touch-LCD-3.5B-GPIO_Pin_Allocation.png
