rguilmet/RTK-Rover/docs/mechanical/ESP32-S3-Touch-LCD-3.5B-details-dimensions.webp

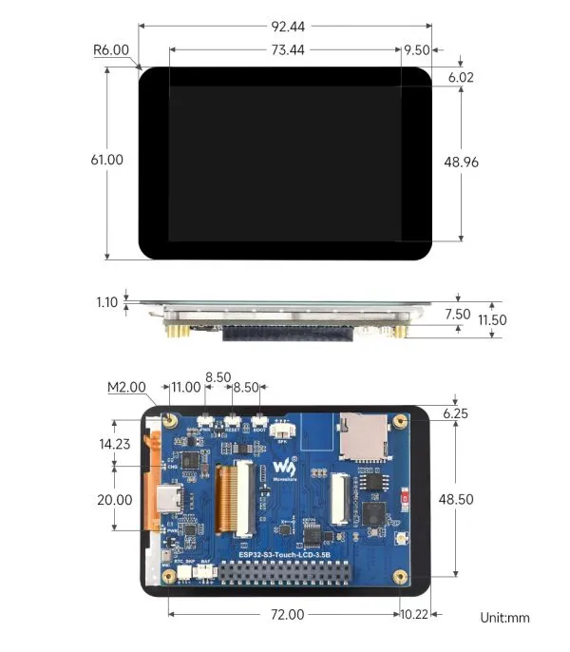
docs/mechanical/ESP32-S3-Touch-LCD-3.5B-details-dimensions.webp
