rguilmet/RTK-Rover/docs/Waveshare-ESP32-S3-Touch-LCD-3.5B-GPIO_Pin_Assignment-rev3.png

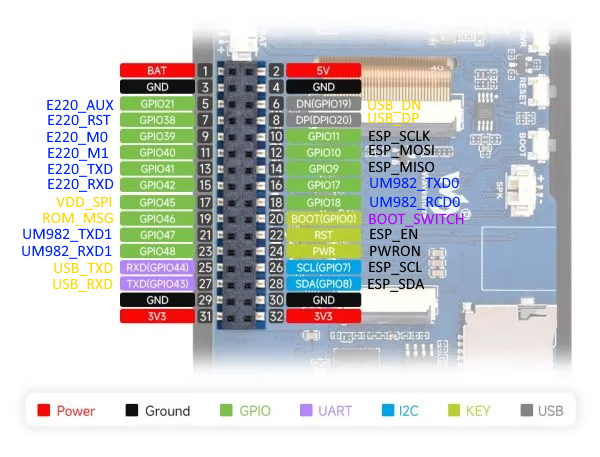
docs/Waveshare-ESP32-S3-Touch-LCD-3.5B-GPIO_Pin_Assignment-rev3.png
