rguilmet/RTK-Rover/docs/mechanical/ESP32-S3-Touch-LCD-3_5B.stp

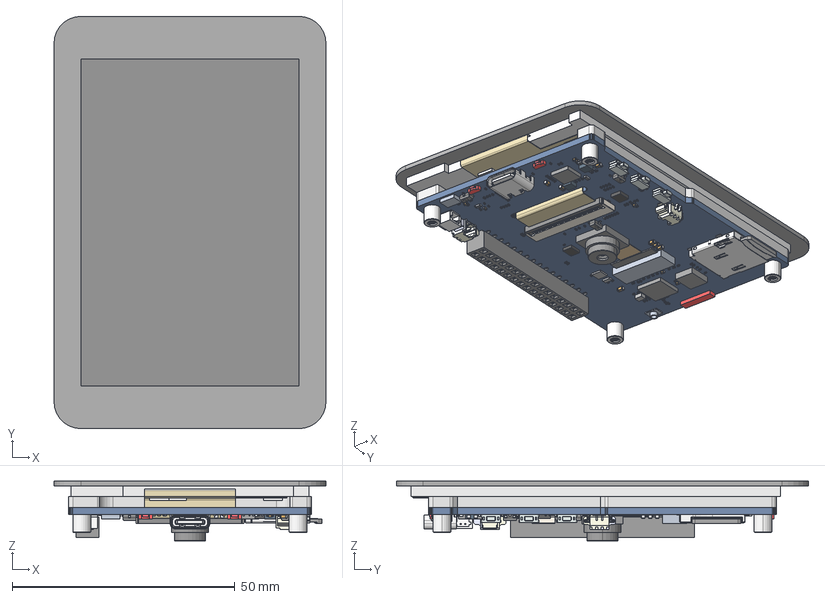
[picture p8: CAD file, 2026-10-23]
docs/mechanical/ESP32-S3-Touch-LCD-3_5B.stp
61.0 x 92.4 x 13.4 mm
JHD0350A007V1
SMTSO-M2X4-4ET x 4
BOARD
USER_LIBRARY-RES_0603-0201_1 x 59
USER_LIBRARY-RES_0603-0201_2 x 59
USER_LIBRARY-RES_0603-0201_3 x 59
USER_LIBRARY-RES_0603-0201_4 x 59
FPC0_5_2H-W__1_2_30034_1 x 40
EXTRUDED-99679
3_1_2_A x 8
USER_LIBRARY-0201_0603M__CAP_1 x 57
USER_LIBRARY-0201_0603M__CAP_2 x 57
USER_LIBRARY-0201_0603M__CAP_3 x 57
3_1_A x 7
EXTRUDED-196805 x 2
_2_1_2_3_4_AF0 x 4
_7_1_2_AF0 x 4
SOT-23 x 3
EXTRUDED-273587
EXTRUDED-273982
EXTRUDED-274377
EXTRUDED-461349
EXTRUDED-461918 x 2
HEADER-SMD-F-2_54-2X16PIN
CAMER
TYPE-C_16PIN-9X3X7_3
SWITCH-TS24CA x 3
MICRO_SD_SOCKET_PU
TF_CARD
LED
HP1_25MM-2P-SMT-HORIZONTAL x 2
MIC
CAMER-CONNECTOR
C3
PITCH1MM-2PIN-SMT-HORIZONTAL
C001
ESP32-S3-TOUCH-LCD-3_5-PMMA
