rguilmet/RTK-Rover/(list of files, cad)

Other CAD files:
docs/mechanical/ESP32-S3-Touch-LCD-3.5B-C.dwg
docs/mechanical/ESP32-S3-Touch-LCD-3.5B.dwg
