rguilmet/RTK-Rover/docs/ESP32-S3-Touch-LCD-3.5-Arduino_Setup.png

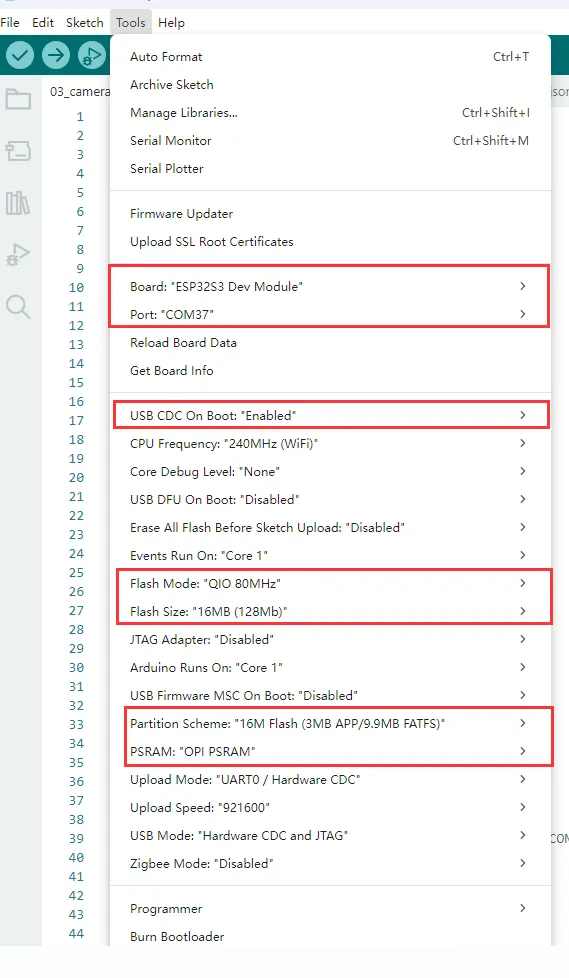
docs/ESP32-S3-Touch-LCD-3.5-Arduino_Setup.png
