rguilmet/RTK-Rover/docs/mechanical/ESP32-S3-Touch-LCD-3.5B-drawing.pdf

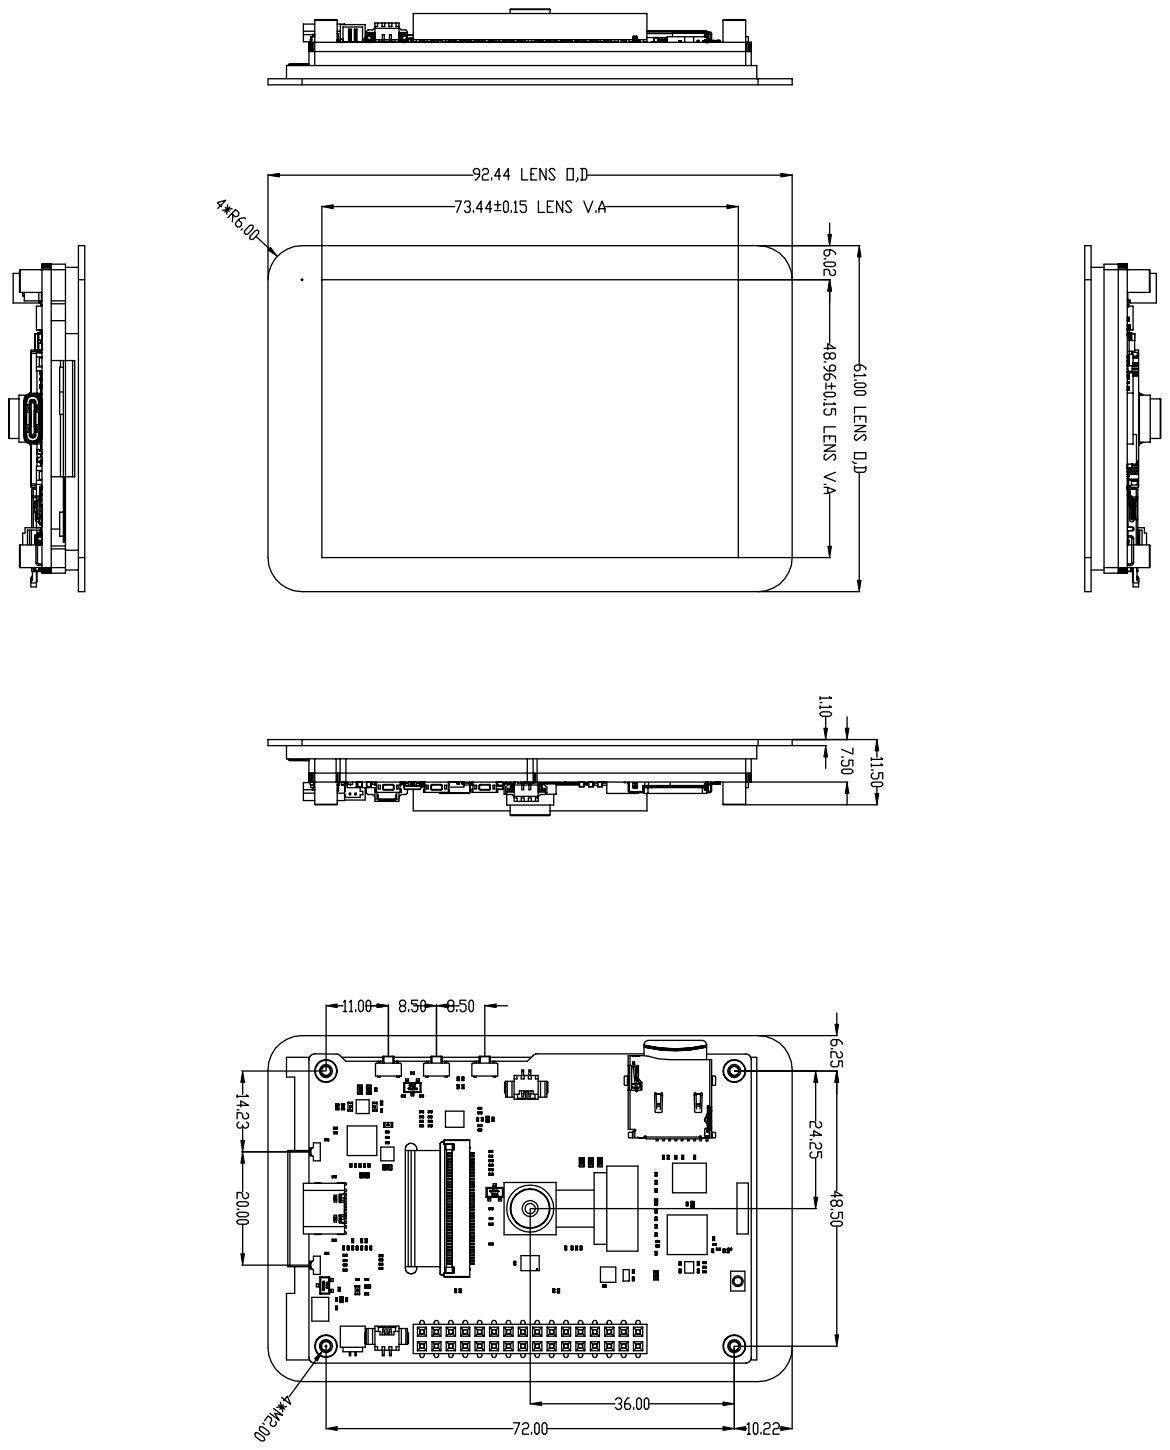
[picture p12: page 1]
