rguilmet/RTK-Rover/src/tca9554/esp_io_expander_tca9554.c

/*
 * SPDX-FileCopyrightText: 2023-2024 Espressif Systems (Shanghai) CO LTD
 *
 * SPDX-License-Identifier: Apache-2.0
 */

#include <inttypes.h>
#include <string.h>
#include <stdlib.h>
#include "esp_bit_defs.h"
#include "esp_check.h"
#include "esp_log.h"
#include "esp_io_expander.h"
#include "esp_io_expander_tca9554.h"
#include "../i2c_bsp/i2c_bsp.h"
#include "freertos/FreeRTOS.h"
#include "freertos/task.h"

/* I2C communication related */
#define I2C_TIMEOUT_MS          (250)
#define I2C_CLK_SPEED           (400000)

#define IO_COUNT                (8)

/* Register address */
#define INPUT_REG_ADDR          (0x00)
#define OUTPUT_REG_ADDR         (0x01)
#define DIRECTION_REG_ADDR      (0x03)

/* Default register value on power-up */
#define DIR_REG_DEFAULT_VAL     (0xff)
#define OUT_REG_DEFAULT_VAL     (0xff)

/**
 * @brief Device Structure Type
 *
 */
typedef struct {
    esp_io_expander_t base;
    i2c_master_bus_handle_t i2c_bus;
    i2c_master_dev_handle_t i2c_handle;
    struct {
        uint8_t direction;
        uint8_t output;
    } regs;
} esp_io_expander_tca9554_t;

static char *TAG = "tca9554";

static esp_err_t read_input_reg(esp_io_expander_handle_t handle, uint32_t *value);
static esp_err_t write_output_reg(esp_io_expander_handle_t handle, uint32_t value);
static esp_err_t read_output_reg(esp_io_expander_handle_t handle, uint32_t *value);
static esp_err_t write_direction_reg(esp_io_expander_handle_t handle, uint32_t value);
static esp_err_t read_direction_reg(esp_io_expander_handle_t handle, uint32_t *value);
static esp_err_t reset(esp_io_expander_t *handle);
static esp_err_t del(esp_io_expander_t *handle);

esp_err_t esp_io_expander_new_i2c_tca9554(i2c_master_bus_handle_t i2c_bus, uint32_t dev_addr, esp_io_expander_handle_t *handle_ret)
{
    ESP_RETURN_ON_FALSE(handle_ret != NULL, ESP_ERR_INVALID_ARG, TAG, "Invalid handle_ret");

    // Allocate memory for driver object
    esp_io_expander_tca9554_t *tca9554 = (esp_io_expander_tca9554_t *)calloc(1, sizeof(esp_io_expander_tca9554_t));
    ESP_RETURN_ON_FALSE(tca9554 != NULL, ESP_ERR_NO_MEM, TAG, "Malloc failed");

    tca9554->i2c_bus = i2c_bus;

    // Add new I2C device (explicitly configure 20ms scl_wait_us to match shared I2C0 bus clock-stretching allowance)
    esp_err_t ret = ESP_OK;
    const i2c_device_config_t i2c_dev_cfg = {
        .dev_addr_length = I2C_ADDR_BIT_LEN_7,
        .device_address = dev_addr,
        .scl_speed_hz = I2C_CLK_SPEED,
        .scl_wait_us = 20000,
    };
    ESP_GOTO_ON_ERROR(i2c_master_bus_add_device(i2c_bus, &i2c_dev_cfg, &tca9554->i2c_handle), err, TAG, "Add new I2C device failed");

    tca9554->base.config.io_count = IO_COUNT;
    tca9554->base.config.flags.dir_out_bit_zero = 1;
    tca9554->base.read_input_reg = read_input_reg;
    tca9554->base.write_output_reg = write_output_reg;
    tca9554->base.read_output_reg = read_output_reg;
    tca9554->base.write_direction_reg = write_direction_reg;
    tca9554->base.read_direction_reg = read_direction_reg;
    tca9554->base.del = del;
    tca9554->base.reset = reset;

    /* Reset configuration and register status */
    ESP_GOTO_ON_ERROR(reset(&tca9554->base), err1, TAG, "Reset failed");

    *handle_ret = &tca9554->base;
    return ESP_OK;
err1:
    i2c_master_bus_rm_device(tca9554->i2c_handle);
err:
    free(tca9554);
    return ret;
}

static esp_err_t read_input_reg(esp_io_expander_handle_t handle, uint32_t *value)
{
    esp_io_expander_tca9554_t *tca9554 = (esp_io_expander_tca9554_t *)__containerof(handle, esp_io_expander_tca9554_t, base);
    if (!i2c_bsp_lock(250)) {
        return ESP_ERR_TIMEOUT;
    }

    uint8_t temp = 0;
    uint8_t reg_addr = INPUT_REG_ADDR;
    esp_err_t ret = i2c_master_transmit_receive(tca9554->i2c_handle, &reg_addr, 1, &temp, sizeof(temp), I2C_TIMEOUT_MS);
    if (ret != ESP_OK && tca9554->i2c_bus != NULL) {
        i2c_master_bus_reset(tca9554->i2c_bus);
        vTaskDelay(pdMS_TO_TICKS(5));
        ret = i2c_master_transmit_receive(tca9554->i2c_handle, &reg_addr, 1, &temp, sizeof(temp), I2C_TIMEOUT_MS);
    }
    i2c_bsp_unlock();
    ESP_RETURN_ON_ERROR(ret, TAG, "Read input reg failed");
    *value = temp;
    return ESP_OK;
}

static esp_err_t write_output_reg(esp_io_expander_handle_t handle, uint32_t value)
{
    esp_io_expander_tca9554_t *tca9554 = (esp_io_expander_tca9554_t *)__containerof(handle, esp_io_expander_tca9554_t, base);
    value &= 0xff;
    if (!i2c_bsp_lock(250)) {
        return ESP_ERR_TIMEOUT;
    }

    uint8_t data[] = {OUTPUT_REG_ADDR, (uint8_t)value};
    esp_err_t ret = i2c_master_transmit(tca9554->i2c_handle, data, sizeof(data), I2C_TIMEOUT_MS);
    if (ret != ESP_OK && tca9554->i2c_bus != NULL) {
        i2c_master_bus_reset(tca9554->i2c_bus);
        vTaskDelay(pdMS_TO_TICKS(5));
        ret = i2c_master_transmit(tca9554->i2c_handle, data, sizeof(data), I2C_TIMEOUT_MS);
    }
    i2c_bsp_unlock();
    ESP_RETURN_ON_ERROR(ret, TAG, "Write output reg failed");
    tca9554->regs.output = value;
    return ESP_OK;
}

static esp_err_t read_output_reg(esp_io_expander_handle_t handle, uint32_t *value)
{
    esp_io_expander_tca9554_t *tca9554 = (esp_io_expander_tca9554_t *)__containerof(handle, esp_io_expander_tca9554_t, base);

    *value = tca9554->regs.output;
    return ESP_OK;
}

static esp_err_t write_direction_reg(esp_io_expander_handle_t handle, uint32_t value)
{
    esp_io_expander_tca9554_t *tca9554 = (esp_io_expander_tca9554_t *)__containerof(handle, esp_io_expander_tca9554_t, base);
    value &= 0xff;
    if (!i2c_bsp_lock(250)) {
        return ESP_ERR_TIMEOUT;
    }

    uint8_t data[] = {DIRECTION_REG_ADDR, (uint8_t)value};
    esp_err_t ret = i2c_master_transmit(tca9554->i2c_handle, data, sizeof(data), I2C_TIMEOUT_MS);
    if (ret != ESP_OK && tca9554->i2c_bus != NULL) {
        i2c_master_bus_reset(tca9554->i2c_bus);
        vTaskDelay(pdMS_TO_TICKS(5));
        ret = i2c_master_transmit(tca9554->i2c_handle, data, sizeof(data), I2C_TIMEOUT_MS);
    }
    i2c_bsp_unlock();
    ESP_RETURN_ON_ERROR(ret, TAG, "Write direction reg failed");
    tca9554->regs.direction = value;
    return ESP_OK;
}

static esp_err_t read_direction_reg(esp_io_expander_handle_t handle, uint32_t *value)
{
    esp_io_expander_tca9554_t *tca9554 = (esp_io_expander_tca9554_t *)__containerof(handle, esp_io_expander_tca9554_t, base);

    *value = tca9554->regs.direction;
    return ESP_OK;
}

static esp_err_t reset(esp_io_expander_t *handle)
{
    ESP_RETURN_ON_ERROR(write_direction_reg(handle, DIR_REG_DEFAULT_VAL), TAG, "Write dir reg failed");
    ESP_RETURN_ON_ERROR(write_output_reg(handle, OUT_REG_DEFAULT_VAL), TAG, "Write output reg failed");
    return ESP_OK;
}

static esp_err_t del(esp_io_expander_t *handle)
{
    esp_io_expander_tca9554_t *tca9554 = (esp_io_expander_tca9554_t *)__containerof(handle, esp_io_expander_tca9554_t, base);

    ESP_RETURN_ON_ERROR(i2c_master_bus_rm_device(tca9554->i2c_handle), TAG, "Remove I2C device failed");
    free(tca9554);
    return ESP_OK;
}
