rguilmet/RTK-Rover/scripts/e220_pacer.py

#!/usr/bin/env python3
# -*- coding: utf-8 -*-
"""
Module: e220_pacer.py
Description: Datasheet-Accurate Hardware-Paced Ebyte E220-900T30S LoRa Driver for RTKBase.
             Parses and CRC24Q-validates raw RTCM3 streams into complete frames and
             transmits each frame intact through the E220 400-byte FIFO using Ebyte
             E220 Manual Section 5.6.2 two-regime AUX + Time-on-Air pacing:
               - Single-subpacket frames (<= 200B): Transfer directly into an idle
                 LLCC68 FIFO without holding AUX LOW; paced deterministically by
                 calibrated LoRa Time-on-Air + receiver UART drain guard delay.
               - Two-subpacket frames (201..400B): Hold AUX LOW while Subpacket 1
                 (200B) transmits over the air, then raise AUX HIGH the instant
                 Subpacket 2 (len - 200) enters the LLCC68 FIFO and begins RF TX;
                 paced by AUX rising edge + Subpacket 2 Time-on-Air + guard delay.
             Includes GPIO 22 hardware reset watchdog if AUX ever locks LOW (>1.5s),
             POSIX exclusive UART locking (TIOCEXCL), startup EEPROM verification,
             and Mode 0 ambient RF noise floor probing (REG1 Bit 5 = 0x20) on CH 75
             (925.125 MHz, Rank #1 cleanest US ISM channel clear of 915 MHz Ecowitt).

Hardware Connections (Raspberry Pi BCM Pins, matching setup_e220.py):
  - E220 M0:    GPIO 18 (BCM) -> Pin 12
  - E220 M1:    GPIO 17 (BCM) -> Pin 11
  - E220 AUX:   GPIO 27 (BCM) -> Pin 13 (Active HIGH = Buffer Empty, LOW = Busy)
  - E220 RESET: GPIO 22 (BCM) -> Pin 15 (Active LOW hardware reset)
  - E220 TX/RX: /dev/ttyAMA0 (UART0 GPIO 14/15)

Author: Roland L. Guilmet & Antigravity
License: MIT
"""

from __future__ import annotations

import argparse
import errno
import gzip
import json
import os
import select
import shutil
import signal
import socket
import struct
import sys
import time
from typing import Optional

try:
    import serial
except ImportError:
    serial = None  # type: ignore

try:
    import RPi.GPIO as GPIO
except ImportError:
    GPIO = None

try:
    import pty
except ImportError:
    pty = None

try:
    import termios
    _TERMIOS_ERRORS: tuple[type[BaseException], ...] = (termios.error,)
except ImportError:
    _TERMIOS_ERRORS = ()


__app_name__ = "e220_pacer"
__version__ = "3.4.1"
__date__ = "2026-11-07"

# Force unbuffered output so systemd journalctl displays entries in real time
if hasattr(sys.stdout, "reconfigure"):
    sys.stdout.reconfigure(line_buffering=True)
if hasattr(sys.stderr, "reconfigure"):
    sys.stderr.reconfigure(line_buffering=True)

# Default Pin Mapping (matches setup_e220.py)
DEFAULT_PIN_M0 = 18
DEFAULT_PIN_M1 = 17
DEFAULT_PIN_AUX = 27
DEFAULT_PIN_RST = 22
DEFAULT_SERIAL_PORT = "/dev/ttyAMA0"
DEFAULT_BAUD = 115200
DEFAULT_PACKET_SIZE = 200

# Inter-frame guard delay after RF completion (allows Rover E220 17.4ms @ 115200 UART drain + 17.6ms margin)
DEFAULT_GUARD_DELAY_S = 0.035  # 35 ms

# Hardware Flow Control & Watchdog Thresholds
AUX_SINGLE_PROBE_S = 0.008     # 8 ms probe for <=200B frames (normally stays HIGH per Sec 5.6.2)
AUX_MULTI_FALL_TIMEOUT_S = 0.050  # 50 ms max wait for AUX falling edge on >200B frames (typical: 2.0 ms)
AUX_RISE_WATCHDOG_S = 1.500    # 1.5 s max AUX LOW before triggering GPIO 22 hardware reset

# Lookups for Auto-Config / Register Decode
BAUD_RATES = {1200: 0b000, 2400: 0b001, 4800: 0b010, 9600: 0b011, 19200: 0b100, 38400: 0b101, 57600: 0b110, 115200: 0b111}
AIR_DATA_RATES = {2.4: 0b010, 4.8: 0b011, 9.6: 0b100, 19.2: 0b101, 38.4: 0b110, 62.5: 0b111}
SUBPACKET_SIZES = {200: 0b00, 128: 0b01, 64: 0b10, 32: 0b11}
POWER_LEVELS = {30: 0b00, 27: 0b01, 24: 0b10, 21: 0b11}

INV_BAUD = {v: k for k, v in BAUD_RATES.items()}
INV_AIR = {0b000: 2.4, 0b001: 2.4, **{v: k for k, v in AIR_DATA_RATES.items()}}
INV_PKT = {v: k for k, v in SUBPACKET_SIZES.items()}
INV_PWR = {v: k for k, v in POWER_LEVELS.items()}

running = True


def sig_handler(signum, frame):
    global running
    running = False


def rtcm_crc24q(data: bytes) -> int:
    """Compute 24-bit RTCM3 CRC24Q over full frame (header + payload + 3-byte CRC). Returns 0 if valid."""
    crc = 0
    for b in data:
        crc ^= (b << 16)
        for _ in range(8):
            crc <<= 1
            if crc & 0x1000000:
                crc ^= 0x1864CFB
        crc &= 0xFFFFFF
    return crc


# =============================================================================
# Bi-Directional LoRa Protocol Definitions (0xAA 0x55 Framing)
# =============================================================================
ROVER_SYNC = b"\xAA\x55"
MSG_ID_TELEMETRY = 0x01
MSG_ID_REQ_SWITCH = 0x02
MSG_ID_ACK_SWITCH = 0x82

# 39-Byte Legacy Uplink Telemetry Frame Format (plen=33):
# sync(2s), mid(B), plen(B), lat(d), lon(d), height(f), h_acc_mm(H), fix(B),
# sats_m(B), sats_s(B), hdg_cdeg(H), bat_pct(B), bat_mv(H), rssi(b), noise(b), seq(B), crc(H)
FMT_TELEMETRY_LEGACY = "<2sBBddfHBBBHBHbbBH"

# 45-Byte Expanded Uplink Telemetry Frame Format (plen=39):
# sync(2s), mid(B), plen(B), lat(d), lon(d), height(f), h_acc_mm(H), fix(B),
# ant2_fix(B), baseline_mm(H), baseline_pitch_cdeg(h), hdg_source(B),
# sats_m(B), sats_s(B), hdg_cdeg(H), bat_pct(B), bat_mv(H), rssi(b), noise(b), seq(B), crc(H)
FMT_TELEMETRY = "<2sBBddfHBBHhBBBHBHbbBH"

# 10-Byte Remote Air-Rate Switch Request Format:
# sync(2s), mid(B), plen(B), target_code(B), target_chan(B), req_id(H), crc(H)
FMT_REQ_SWITCH = "<2sBBBBHH"

# 11-Byte Remote Air-Rate Switch Acknowledge Format:
# sync(2s), mid(B), plen(B), req_id(H), status(B), delay_ms(H), crc(H)
FMT_ACK_SWITCH = "<2sBBHBHH"


def crc16_ccitt(data: bytes) -> int:
    """Standard CRC16-CCITT (False: poly 0x1021, init 0xFFFF, no final XOR)."""
    crc = 0xFFFF
    for b in data:
        crc ^= (b << 8)
        for _ in range(8):
            if crc & 0x8000:
                crc = ((crc << 1) ^ 0x1021) & 0xFFFF
            else:
                crc = (crc << 1) & 0xFFFF
    return crc


class E220Pacer:
    def __init__(
        self,
        port: str = DEFAULT_SERIAL_PORT,
        baud: int = DEFAULT_BAUD,
        packet_size: int = DEFAULT_PACKET_SIZE,
        guard_delay_s: float = DEFAULT_GUARD_DELAY_S,
        pin_m0: int = DEFAULT_PIN_M0,
        pin_m1: int = DEFAULT_PIN_M1,
        pin_aux: int = DEFAULT_PIN_AUX,
        pin_rst: int = DEFAULT_PIN_RST,
        auto_config: bool = False,
        air_rate_kbps: float = 19.2,
        power_dbm: int = 21,
        channel: int = 75,
        verbose: bool = False,
        quiet: bool = False,
        log_dir: str = "~/rover_logs",
        log_retention_days: int = 30,
        max_log_mb: int = 50,
        compress_logs: bool = True,
        no_csv: bool = False,
        no_interleave: bool = False,
    ):
        self.port_name = port
        self.baud = baud
        self.packet_size = packet_size
        self.guard_delay_s = guard_delay_s
        self.pin_m0 = pin_m0
        self.pin_m1 = pin_m1
        self.pin_aux = pin_aux
        self.pin_rst = pin_rst
        self.auto_config = auto_config
        self.air_rate_kbps = air_rate_kbps
        self.power_dbm = power_dbm
        self.channel = channel
        self.verbose = verbose
        self.quiet = quiet
        self.ser: Optional[serial.Serial] = None
        self.gpio_available = GPIO is not None
        self.rssi_reg_enabled = False

        # Bi-Directional LoRa Uplink State
        self.uplink_buf = bytearray()
        self.last_rover_telemetry: dict = {}
        self.last_rover_rx_time = 0.0
        self.uplink_packets_received = 0
        self.uplink_crc_errors = 0
        self.rate_switch_count = 0
        self.watchdog_rate_switch_time = 0.0
        self.watchdog_rate_revert_time = 0.0
        self.fallback_air_rate = 19.2
        self.active_air_rate = air_rate_kbps

        # Log Retention & Storage
        resolved_log_dir = os.path.expanduser(log_dir)
        if resolved_log_dir.startswith("/root") or resolved_log_dir == "/root":
            if os.path.isdir("/home/pi"):
                resolved_log_dir = "/home/pi/rover_logs"
            elif os.environ.get("SUDO_USER") and os.path.isdir(f"/home/{os.environ.get('SUDO_USER')}"):
                resolved_log_dir = f"/home/{os.environ.get('SUDO_USER')}/rover_logs"
            else:
                # Find the first non-root interactive user directory in /home
                try:
                    candidates = [
                        os.path.join("/home", u) for u in os.listdir("/home")
                        if os.path.isdir(os.path.join("/home", u)) and not u.startswith(".")
                    ]
                    if candidates:
                        resolved_log_dir = os.path.join(candidates[0], "rover_logs")
                except Exception:
                    pass
        self.log_dir = resolved_log_dir
        self.log_retention_days = log_retention_days
        self.max_log_mb = max_log_mb
        self.compress_logs = compress_logs
        self.enable_csv = not no_csv
        self.current_log_date = ""
        self.current_log_file = None

        # Pre-create log directory immediately on startup with full access
        if self.enable_csv:
            try:
                os.makedirs(self.log_dir, exist_ok=True)
                os.chmod(self.log_dir, 0o777)
                # If created in /root, also attempt to symlink into /home candidate for convenience
                if self.log_dir.startswith("/root"):
                    for u in os.listdir("/home"):
                        uhome = os.path.join("/home", u)
                        if os.path.isdir(uhome) and not u.startswith("."):
                            ulink = os.path.join(uhome, "rover_logs")
                            if not os.path.exists(ulink):
                                try:
                                    os.symlink(self.log_dir, ulink)
                                except OSError:
                                    pass
            except OSError:
                pass

        # Telemetry counters
        self.total_bytes_in = 0
        self.total_bytes_out = 0
        self.total_packets_sent = 0
        self.total_subpackets_sent = 0
        self.total_wait_time_s = 0.0
        self.watchdog_resets = 0
        self.src_crc_errors = 0
        self.src_orphan_bytes = 0
        self.backlog_shed_frames = 0
        self.rtcm_stats: dict[int, int] = {}

        # Adaptive Constellation Interleaver State
        self.enable_interleave = not no_interleave
        self.seen_secondary_types: set[int] = set()
        self.epoch_counter = 0
        self.last_epoch_start_time = 0.0
        self.interleave_dropped_frames = 0

    def estimate_subpacket_air_s(self, n_bytes: int) -> float:
        """
        Estimate single-subpacket LoRa Time-on-Air (seconds) for E220-900T30S (LLCC68).
        Calibrated directly against Test _022 hardware AUX_low telemetry (t_uart + AUX_low = 165.0 ms
        -> 148.1 ms true Time-on-Air for 200B @ 19.2 kbps; ~0.68 net payload coding efficiency after
        LoRa preamble, explicit header, CRC16, FEC coding rate, and 3-char UART idle detect):
          - @ 38.4 kbps: 200B -> 82.2 ms, 144B -> 65.0 ms, 122B -> 58.3 ms, 27B -> 29.2 ms
          - @ 19.2 kbps: 200B -> 148.4 ms, 144B -> 114.0 ms, 122B -> 100.6 ms, 27B -> 42.3 ms
        """
        if n_bytes <= 0:
            return 0.0
        rate_bps = max(self.air_rate_kbps, 2.4) * 1000.0
        return 0.016 + ((float(n_bytes) + 16.0) * 8.0) / (rate_bps * 0.68)

    @staticmethod
    def _safe_flush(ser_obj: "serial.Serial") -> bool:
        """Drain UART TX buffer via tcdrain(), returning False cleanly if interrupted by SIGTERM/SIGINT (EINTR)."""
        while True:
            try:
                ser_obj.flush()
                return True
            except _TERMIOS_ERRORS + (OSError,) as e:
                err_no = e.args[0] if getattr(e, "args", None) else None
                if err_no == errno.EINTR:
                    if not running:
                        return False
                    continue
                if not running:
                    return False
                raise

    def _open_operational_uart(self) -> None:
        if serial is None:
            raise RuntimeError("pyserial is not installed.")
        if self.ser and self.ser.is_open:
            self.ser.close()
        try:
            self.ser = serial.Serial(self.port_name, self.baud, timeout=0.05, exclusive=True)
            excl_tag = "exclusive=True (TIOCEXCL locked)"
        except TypeError:
            self.ser = serial.Serial(self.port_name, self.baud, timeout=0.05)
            excl_tag = "exclusive=N/A"
        self.ser.reset_input_buffer()
        self.ser.reset_output_buffer()
        print(f"[UART] Opened {self.port_name} @ {self.baud} bps ({excl_tag})", flush=True)

    @staticmethod
    def _decode_registers_str(regs: bytes) -> str:
        if len(regs) < 6:
            return "INVALID"
        addh, addl, r0, r1, ch, r3 = regs[0], regs[1], regs[2], regs[3], regs[4], regs[5]
        u_baud = INV_BAUD.get((r0 >> 5) & 0x07, 0)
        a_rate = INV_AIR.get(r0 & 0x07, 0.0)
        pkt_sz = INV_PKT.get((r1 >> 6) & 0x03, 0)
        tx_pwr = INV_PWR.get(r1 & 0x03, 0)
        rssi_reg = "ON" if (r1 & 0x20) else "OFF"
        mode_s = "Fixed" if (r3 & 0x40) else "Transparent"
        lbt_s = "ON" if (r3 & 0x10) else "OFF"
        rssi_byte = "ON" if (r3 & 0x80) else "OFF"
        freq = 850.125 + ch
        return (
            f"ADD=0x{addh:02X}{addl:02X} REG0=0x{r0:02X} REG1=0x{r1:02X} CHAN=0x{ch:02X}({ch}) REG3=0x{r3:02X} -> "
            f"UART={u_baud} | Air={a_rate}k | Pkt={pkt_sz}B | Pwr={tx_pwr}dBm | "
            f"RSSI_Reg={rssi_reg} | Freq={freq:.3f}MHz | Mode={mode_s} | LBT={lbt_s} | RSSI_Byte={rssi_byte}"
        )
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
