rguilmet/RTK-Rover/(commit log)

2026-10-23 v0.1.0: Initial RTK Rover architecture, BSP drivers, LVGL 9 UI, and UART/Nav modules
    [ESP32-S3-Touch-LCD-3.5B-C.dwg, ESP32-S3-Touch-LCD-3.5B.dwg, ESP32-S3-Touch-LCD-3_5B.stp, Waveshare-ESP32-S3-Touch-LCD-3.5B-GPIO_Pin_Assignment-rev3.csv, Waveshare-ESP32-S3-Touch-LCD-3.5B-GPIO_Pin_Assignment-rev3.xlsx, custom_large_partitions.csv, waypoints.csv]
2026-10-23 v0.1.1: Switch project license to GPLv3 to match Magnetic Field Scanner
2026-10-23 v0.1.6: Set default E220 packet size to 128 bytes (REG1=0x43) with 38.4k air rate and 115200 UART
2026-10-23 v0.1.7: Set E220 transparent UART baud rate to 57600 (REG0=0xC6) to prevent 1400B FIFO overrun
    [e220_driver.cpp, lvgl_port.c, settings_manager.cpp, settings_manager.h, user_config.h]
2026-10-24 v0.1.8: Fix C/C++ header guards, remove unused touch header, and rename rtc_bsp_init for clean build
    [RTK_Rover.ino, esp_lcd_axs15231b.c, esp_lcd_axs15231b.h, lvgl_port.c, lvgl_port.h, rtc_bsp.cpp, rtc_bsp.h, settings_manager.h]
2026-10-24 v0.1.9: Replace lv_label_set_text_fmt with snprintf + lv_label_set_text to fix float formatting crash
    [lvgl_port.c, user_config.h]
2026-10-24 v0.1.10: Resolve LVGL 9.6.0 and SensorLib deprecation warnings in lv_conf.h and rtc_bsp.cpp
    [rtc_bsp.cpp, user_config.h]
2026-10-24 v0.1.11: Fix I2C mutex/touch read, SD_MMC mount, nav bar, and boot self-tests
    [RTK_Rover.ino, axp2101_bsp.c, e220_driver.cpp, e220_driver.h, i2c_bsp.c, i2c_bsp.h, imu_bsp.c, lvgl_port.c]
2026-10-24 v0.1.12: Core 1 exclusive I2C0 polling (100kHz + 1Hz RTC cache), GSV SVs in view, SD_MMC EXIO3 HIGH fix, and VERSIONA COM2 diagnostics
    [RTK_Rover.ino, e220_driver.cpp, i2c_bsp.c, lvgl_port.c, rover_api.h, rtc_bsp.cpp, um982_driver.cpp]
2026-10-24 v0.1.14: Remove duplicate SVs on Tile 0, replace UTF-8 plus-minus with ASCII +/-, serialize Core 1 I2C under lvgl_lock, and add 3-stage SD mount fallback
    [RTK_Rover.ino, axp2101_bsp.c, e220_driver.cpp, i2c_bsp.c, imu_bsp.c, lvgl_port.c, settings_manager.cpp, um982_driver.cpp]
2026-10-25 v0.1.15: Fix USB CDC blocking when serial disconnected, stream UNIHEADINGA for moving baseline, omit redundant GPHDT/GPTHS on COM1, and add Case-part2 CAD model
    [RTK_Rover.ino, um982_driver.cpp, user_config.h]
2026-10-25 feat: v0.2.0 SemVer bump, tactical background grid, ASCII steer cues, SoftAP fallback, and button state color sync
2026-10-25 feat: reposition REC button to bottom-right of tactical grid and enforce clean ASCII two-state REC ON / REC OFF
2026-10-25 fix: swap Wi-Fi and Units buttons, fix NMEA flush pipeline, add web server to loop, and harden Wi-Fi STA connection
    [RTK_Rover.ino, lvgl_port.c, nmea_logger.cpp, settings_manager.cpp, web_server.cpp]
2026-10-25 feat: v0.2.1 SemVer bump, add Hdg and Pitch telemetry HUD under Tactical Grid, and simplify steer cues
2026-10-25 feat: v0.2.3 Header Slave antenna badge, unfreeze IMU reading, and Tare reset button
2026-10-25 feat: v0.2.4 eliminate LVGL 9 deprecation warnings and align UM982 heading fix length
    [lvgl_port.c, um982_driver.cpp, user_config.h]
2026-10-26 feat: v0.2.5 3-row header, 2Hz/1Hz NMEA rates, GNGGAH parsing, and QMI8658 IMU unfreezing
2026-10-26 fix: v0.2.6 resolve snprintf argument count mismatch causing Core 1 LoadProhibited crash
    [lvgl_port.c, user_config.h]
2026-10-26 v0.2.7: Row 1 header re-alignment, Wi-Fi 2.4GHz diagnostic scanner & AP channel lock, IMU silicon register fix & live telemetry
    [RTK_Rover.ino, imu_bsp.c, lvgl_port.c, settings_manager.cpp, user_config.h, web_server.cpp]
2026-10-26 v0.2.8: Unblock IMU sensor polling from LVGL mutex contention, invert Z-axis roll, and implement FreeRTOS beepQueue
    [RTK_Rover.ino, imu_bsp.c, lvgl_port.c, user_config.h]
2026-10-26 v0.2.9: Correct bubble level axes for portrait mode, add brightness & volume controls, add dedicated antenna diagnostics & HDOP card, disable horizontal swipe, and simplify BOOT button
    [RTK_Rover.ino, imu_bsp.c, lvgl_port.c, user_config.h]
2026-10-26 fix: add RoverBeep_t and beepQueue declarations in RTK_Rover.ino
    [RTK_Rover.ino]
2026-10-27 feat(waypoints): standardize waypoints.csv schema to match surveyed pins and upgrade validate_waypoints.py to v1.1.0
    [waypoints.csv]
2026-10-27 feat(waypoints): populate root waypoints.csv with sample boundary points
    [waypoints.csv]
2026-10-27 fix(waypoints): ensure only label, lat, and lon are required and all other fields handle empty values
    [validate_waypoints.py, waypoint_manager.cpp]
2026-10-27 feat(cogo): add multi-deed network solver and KML ingestion scripts, update waypoints.csv
    [waypoints.csv]
2026-10-27 fix(ui): use lv_font_montserrat_12 for compass intercardinals and resolve LVGL 9 deprecation
    [lvgl_port.c]
2026-10-27 fix(ui): redistribute tile 2 layout, remove redundant title, eliminate status/settings overlap
    [lvgl_port.c]
2026-10-27 fix(ui): shift tare button to right edge, remove redundant compass title, redistribute vertical spacing
    [lvgl_port.c]
2026-10-27 fix(ui): increase header coords font to 14pt and clean up tile 5 title
    [lvgl_port.c]
2026-10-27 fix(i2c): add 20ms scl_wait_us, 25ms xfer timeout, and 5ms settle delay to prevent cascade bus resets
    [i2c_bsp.c]
2026-10-27 fix(i2c): relocate scl_wait_us to i2c_device_config_t and bump to v0.2.14
    [i2c_bsp.c, user_config.h]
2026-10-27 feat(waypoints): update cogo network solver to v1.1.0 with boundary calls and monument descriptions
    [waypoints.csv]
2026-10-27 feat(waypoints): add adjoiner waypoint sets and road arc solver
    [gray_waypoints.csv, haslam_waypoints.csv]
2026-10-27 feat(ui): add Tile 3 CSV file selector, expand notes buffer for Tile 1 marquee autoscroll, and standardize waypoints-*.csv naming (v0.2.16)
    [waypoints-gray.csv, waypoints-guilmet.csv, waypoints-haslam.csv]
2026-10-27 feat(waypoints): sanitize project root with generic waypoints.csv and move personal deed waypoints to reference/ (v0.2.17)
    [waypoints-gray.csv, waypoints-guilmet.csv, waypoints-haslam.csv, waypoints.csv]
2026-10-27 feat(gnss): add baseline sanity gate, kinematic COG fallback, enlarged Row 4 coordinates, and web download fix (v0.2.18)
    [RTK_Rover.ino, lvgl_port.c, rover_api.h, um982_driver.cpp, user_config.h, web_server.cpp]
2026-10-27 fix(gnss): correct UM982 baseline length to meters (0.555), fix Row 3 heading badge, and bypass Chrome .log download block (v0.2.19)
    [lvgl_port.c, um982_driver.cpp, user_config.h, web_server.cpp]
2026-10-27 fix(gnss): use centimeter units for CONFIG HEADING LENGTH (55.5 cm) and set MODE ROVER SURVEY (v0.2.19)
    [um982_driver.cpp]
2026-10-27 feat(ui): add Tactical Grid Target Heading HUD with green on-target cue and fix antenna pitch display (v0.2.19)
    [lvgl_port.c]
2026-10-27 feat(ui): update Row 3 badge labels to SLV FIX, SLV FLT, HDG COG, HDG HLD, and HDG --- (v0.2.19)
    [lvgl_port.c]
2026-10-27 feat(ui): implement Course-Up Tactical Guidance Director with tolerance wedges and arrowheads (v0.2.20)
    [lvgl_port.c, user_config.h]
2026-10-27 fix(um982): correct CONFIG query command and synchronize MODE response logging (v0.2.21)
    [um982_driver.cpp, user_config.h]
2026-10-27 fix(ui): lower target pin position and terminate track arrow on outer radius (v0.2.22)
    [lvgl_port.c, user_config.h]
2026-10-27 fix(storage): standardize NMEA log to .txt and simplify web portal downloads (v0.2.23)
    [nmea_logger.cpp, user_config.h, web_server.cpp]
2026-10-27 feat(logging): add Serial SD logger, Tile 2 LOG button, and screenshots folder (v0.2.24)
2026-10-27 fix(wifi): prevent heap corruption crash on Wi-Fi start with recursive LVGL lock and connection guard (v0.2.25)
    [lvgl_port.c, user_config.h, web_server.cpp]
2026-10-27 fix(ui): restore USB CDC boot diagnostics, revert recursive LVGL mutex, and eliminate UI lockups (v0.2.26)
    [RTK_Rover.ino, lvgl_port.c, serial_logger.cpp, serial_logger.h, user_config.h]
2026-10-27 fix(i2c): eliminate cascade bus timeouts, add 9-clock bus clear, and throttle/debounce touch polling (v0.2.27)
    [i2c_bsp.c, lvgl_port.c, user_config.h]
2026-10-27 fix(touch): restore native touch polling, eliminate manual gpio matrix disconnection, and fix UI responsiveness (v0.2.28)
    [i2c_bsp.c, lvgl_port.c, user_config.h]
2026-10-28 fix(touch): remove gesture-only filter, disable nav scroll, add click padding, and clamp polling latency (v0.2.29)
    [lvgl_port.c, user_config.h]
2026-10-28 fix(touch): restore proven v0.2.24 touch, navigation, and I2C baseline with surgical Wi-Fi fix (v0.2.30)
    [RTK_Rover.ino, i2c_bsp.c, lvgl_port.c, user_config.h]
2026-10-28 feat(ui): restore touch audio feedback, instrument touch diagnostics, and fix button unresponsiveness (v0.2.31)
    [lvgl_port.c, settings_manager.cpp, settings_manager.h, user_config.h]
2026-10-28 fix(storage): add multi-tier fallback, Wi-Fi credential preservation, and .bak backups (v0.2.32)
    [settings_manager.cpp, user_config.h]
2026-10-28 feat(ui): redesign Tile 4 diagnostics with pinned log deck, flex spacing, and observer telemetry (v0.2.34)
    [lvgl_port.c, user_config.h]
2026-10-28 v0.2.35: Add 6-DOF IMU telemetry (accel Z & 3-axis gyro), auto-wrap diagnostic labels, and insert dedicated Base Station section
2026-10-28 fix(serial_logger): suppress 'Serial' redefined warning by undefining macro before redirection
    [serial_logger.h]
2026-10-28 v0.2.36: Add ANT2 coordinates, fix Base Station telemetry delivery, and distinguish Storage row color
    [lvgl_port.c, rover_api.h, um982_driver.cpp, user_config.h]
2026-10-28 v0.2.37: Redesign Tile 2 with <DERIVED> prefix, collision-free numbering, and streamlined workflow
    [lvgl_port.c, rover_api.h, user_config.h, waypoint_manager.cpp, waypoint_manager.h]
2026-10-28 feat(scripts): Add convert_deeds_to_markdown.py with OCR, multi-parcel parsing, and CAD DXF generation
2026-10-28 feat(scripts): Isolate DXF parcel layers, export standalone drawings, and resolve ROW/easement geometry
    [convert_deeds_to_markdown.py]
2026-10-28 feat(scripts): Support full-word bearings, tangent right-of-way curves, and fast transcript caching
2026-10-28 fix(radio): resolve E220 sniffer false CRC errors and optimize RTCM burst drain (v0.2.41)
    [e220_driver.cpp, user_config.h]
2026-10-28 feat(settings): persist NMEA logging state across reboots & ungate RTCM sniffer frame counting (v0.2.42)
    [RTK_Rover.ino, e220_driver.cpp, lvgl_port.c, settings_manager.cpp, settings_manager.h, user_config.h]
2026-10-29 feat(storage): add raw RTCM stream logger to SD card and replace redundant Tile 5 button with RTCM LOG toggle (v0.2.43)
    [RTK_Rover.ino, e220_driver.cpp, lvgl_port.c, rtcm_logger.cpp, rtcm_logger.h, settings_manager.cpp, settings_manager.h, user_config.h]
2026-10-29 fix(radio): align E220 defaults to 115200 baud, 200B packets, 62.5k air rate & buffer COM2 TX (v0.2.43)
    [settings_manager.cpp, um982_driver.cpp, user_config.h]
2026-10-29 fix(radio): align E220 UART baud rate to 38400 bps across firmware, settings, and scripts (v0.2.44)
    [settings_manager.cpp, setup_e220.py, test_e220_link.py, user_config.h]
2026-10-29 serial_logger: add millisecond-precision timestamps per record to monitor and SD log (v0.2.46)
2026-10-29 fix(web_server): replace unicode emojis with pure ASCII labels and add utf-8 charset headers (v0.2.49)
    [user_config.h, web_server.cpp]
2026-11-01 commit updates missed from multiple sessions and capture manual changes (v0.2.55)
    [RTK_Rover.ino, e220_driver.cpp, e220_driver.h, e220_pacer.py, lvgl_port.c, rover_api.h, scan_e220_channels.py, set_e220_power.py]
2026-11-03 feat: Phase 3 cadastral schema, generic cogo_solver engine, and reference dataset
    [control_points.sample.csv]
2026-11-03 fix(cogo): escape XML entities and emit LineString for open traverses for Google My Maps compatibility (v1.2.0)
    [cogo_solver.py]
2026-11-04 feat(ui): calibrate LoRa signal meter to -110..-25 dBm with multi-tier color ladder (v0.2.57)
2026-11-04 feat(hw): add M0/M1 pin continuity self-test, icon-only Wi-Fi, and Row 2 LoRa label (v0.2.58)
2026-11-04 feat(ui,audio): implement Phase 2 3x4 button grid, +57px viewport boost, and ES8311 proximity audio (v0.3.0)
    - Consolidate Tile 1 Quick Settings into a 3x4 grid (12 buttons, 96x26px) for VOL, AUD, BRI, NMEA, ROUTE, RTCM, TELEM, IMU, TOUCH, WIFI, UNITS, and LORA
    - Relocate logging controls from Tile 4 to Tile 1, expanding Tile 4 scrollable diagnostics viewport by +57px
    - Implement distance-proportional ES8311 proximity Geiger counter audio synthesis and stepped beeps with settings persistence
    - Preserve button clicks, screenshot audio chimes, and survey pin chimes independently
    - Keep Tile 3 TARE / RST button on Compass & Level tile intact
    - Bump firmware version to v0.3.0
2026-11-04 style(ui): expand Tile 1 button grid white space, unbracket labels, and separate Log Pin status
    - Remove unnecessary '[' and ']' brackets across all 12 buttons to eliminate label crowding
    - Increase button grid white space: 8px vertical gap, 9px horizontal gap, 94x27px button size
    - Re-space upper survey elements to give 8px clean separation between LOG PIN NOW and status label
    - Lower Wi-Fi status banner to y=332 for balanced vertical breathing room
2026-11-04 feat(telemetry): implement Phase 3 bi-directional LoRa link and dynamic air-rate switching v0.4.0
    - Added 39-byte packed binary uplink telemetry engine (0xAA 0x55, CRC16-CCITT)
    interleaving ground-tip position, accuracy, fix, sats, heading, and battery
    into the half-duplex quiet window every 5 seconds.
    - Hooked Tile 1 LORA button to initiate over-the-air air-rate negotiations
    (19.2k <-> 9.6k) with zero sudo passwords or service restarts.
    - Upgraded e220_pacer.py to v3.0.0 with quiet-window receiver, live console lines,
    atomic /run/rtk_rover_status.json in RAM, and rolling daily CSV log with 30-day
    retention pruning, gzip compression, and 50MB hard FIFO ceiling.
    - Added 60s rollback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
    [RTK_Rover.ino, e220_driver.cpp, e220_driver.h, e220_pacer.py, lvgl_port.c, rover_api.h, rover_telemetry.cpp, rover_telemetry.h]
2026-11-04 fix(build): resolve lv_obj_remove_flag deprecation and volatile increment warnings
    [e220_driver.cpp, lvgl_port.c]
2026-11-04 fix(lora): resolve rate switch lock, pacer starvation & touch lag (v0.5.1)
    [e220_driver.cpp, e220_driver.h, e220_pacer.py, lvgl_port.c, rover_telemetry.cpp]
2026-11-04 fix(ui): restore serial logging button to Tile 1 and set REC to press event
    [lvgl_port.c]
2026-11-04 fix(ui): swap positions of SERIAL and NMEA buttons on Tile 1
    [lvgl_port.c]
2026-11-05 fix: resolve Montserrat font compilation error and implement adaptive constellation interleaver in e220_pacer v3.2.0
    [e220_pacer.py, lvgl_port.c, user_config.h]
2026-11-05 fix(security): handle Windows subprocess utf-8 decoding in check_secrets v1.1.1
    [check_secrets.py]
2026-11-05 Phase 5: Navigation & heading enhancements with cadastral polygon ordering
    [waypoints.csv]
2026-11-05 fix(telemetry): synchronize telemetry feed on Core 1, align ANT2 status with moving baseline, and use ASCII deg
    [RTK_Rover.ino, e220_driver.cpp, e220_pacer.py, lvgl_port.c, rover_telemetry.cpp, um982_driver.cpp, user_config.h]
2026-11-05 fix(pacer): auto-detect non-pi user home dir for rover_logs and pre-create on startup
    [e220_pacer.py]
2026-11-05 docs(e220): overhaul e220-reference.md to v2.0 covering link capacity, adaptive interleaving, 45B telemetry, and remote air-rate negotiation
2026-11-05 feat(power): Dual-Power USB/Battery Hot-Swap Architecture, Row 1 Spacing Overhaul & Sensor Offline Badging v0.7.0
    [RTK_Rover.ino, axp2101_bsp.c, axp2101_bsp.h, e220_pacer.py, lvgl_port.c, lvgl_port.h, rover_api.h, rover_telemetry.cpp]
2026-11-06 fix(field-test): resolve wifi portal ip, vbus debounce, heading gyro drift, and walk hold (v0.7.1)
    [RTK_Rover.ino, axp2101_bsp.c, lvgl_port.c, web_server.cpp, web_server.h]
2026-11-06 fix(wifi): bump version to v0.7.1 and resolve station mode auth/reconnect failure
    [user_config.h, web_server.cpp]
2026-11-06 fix(wifi): resolve WL_STOPPED (254) driver halt in ESP32 core v3.3.12 and fix toggle log
    [lvgl_port.c, web_server.cpp]
2026-11-06 feat(ui,wifi): bump version to v0.7.2 and add multi-state Wi-Fi button and header colors
2026-11-06 v0.7.4: Fix Wi-Fi STA task affinity, settling delay, and handshake stability
    [user_config.h, web_server.cpp]
2026-11-06 fix(wifi,mem): resolve DRAM0 exhaustion blocking esp_wifi_init and bump to v0.7.5
    [RTK_Rover.ino, lvgl_port.c, nmea_logger.cpp, rtcm_logger.cpp, serial_logger.cpp, user_config.h, waypoint_manager.cpp, waypoint_manager.h]
2026-11-06 docs: sync project documentation to v0.7.5 and codify ESP32-S3 DRAM0 vs PSRAM rules
2026-11-06 fix(i2c): add UPS warm-reset GPIO SCL bus-clear and TCA9554/ES8311 recovery (v0.7.6)
    [RTK_Rover.ino, audio_codec_ctrl_i2c.c, esp_io_expander_tca9554.c, i2c_bsp.c, i2c_bsp.h, lvgl_port.c, user_config.h]
2026-11-06 v0.7.7: Eliminate waypoint/file button lag, fix Wi-Fi toggle races, and stop SD log drops
    [RTK_Rover.ino, lvgl_port.c, serial_logger.cpp, settings_manager.cpp, user_config.h, waypoint_manager.cpp, waypoint_manager.h, web_server.cpp]
2026-11-07 v0.7.7: Update Smart-Pole & Android App plan (ESP32-S3-Touch-LCD-1.47B, 24-30in beam, USB pack)
2026-11-07 docs: Update Smart Pole plan (v2.1.0) for Waveshare 3.49-V2, 18650, NDP6020P + 2N3904 switch & MT3608
2026-11-07 docs: Consolidate all shared drivers, engines & datasheets into Field_Instrument_Core library (v2.4.0)
2026-11-07 docs: Add beam-mounted MMC5983MA 9-DOF compass & UM982 auto-calibration to plan (v2.6.0)
2026-11-07 docs: Add MMC5983MA datasheets/schematic and Qwiic wiring details to plan
2026-11-07 v0.8.0: Phase 8 Single-UART UM982 COM1 consolidation, receiver state query, and auto-detected MMC5983MA 9-DOF compass
2026-11-07 docs(schematics): add complete wiring diagrams for ESP32-S3-Touch-LCD-3.5B (v0.8.0) and ESP32-S3-Touch-LCD-3.49-V2 Smart Pole
2026-11-07 docs(schematics): add GPIO pin assignment CSVs for 3.5B (rev4) and 3.49-V2 Smart Pole
    [Waveshare-ESP32-S3-Touch-LCD-3.49-V2-GPIO_Pin_Assignment.csv, Waveshare-ESP32-S3-Touch-LCD-3.5B-GPIO_Pin_Assignment-rev4.csv]
